trabem/home_sense_meteostation/presentation/PXL_20261026_005536355.jpg

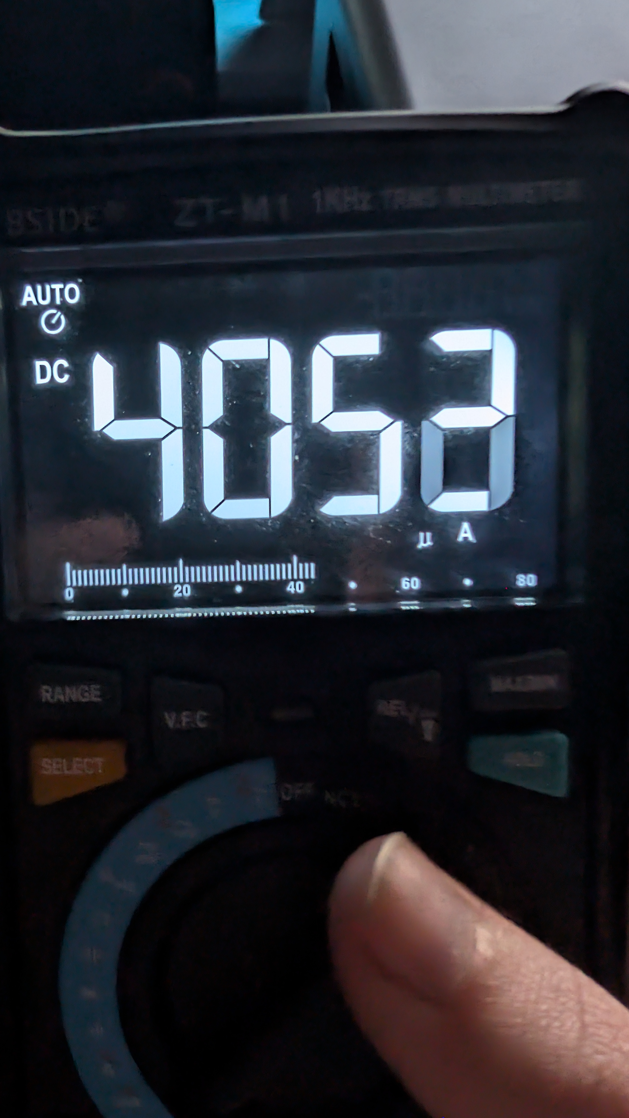
presentation/PXL_20261026_005536355.jpg
