trabem/home_sense_meteostation/presentation/PXL_20261026_134208514.jpg

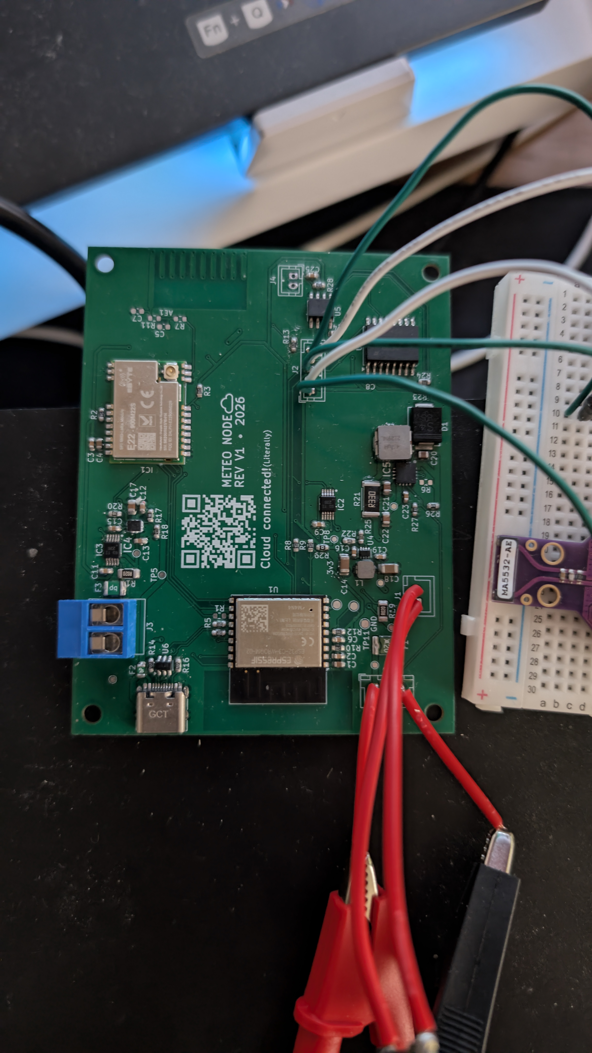
presentation/PXL_20261026_134208514.jpg
