trabem/home_sense_meteostation/presentation/Meteostation_Final_Project_UA_v2_Architecture.pptx

ФІНАЛЬНИЙ ПРОЄКТ КУРСУ

Автономна
метеостанція

Від живлення та датчиків —
до надійної передачі даних

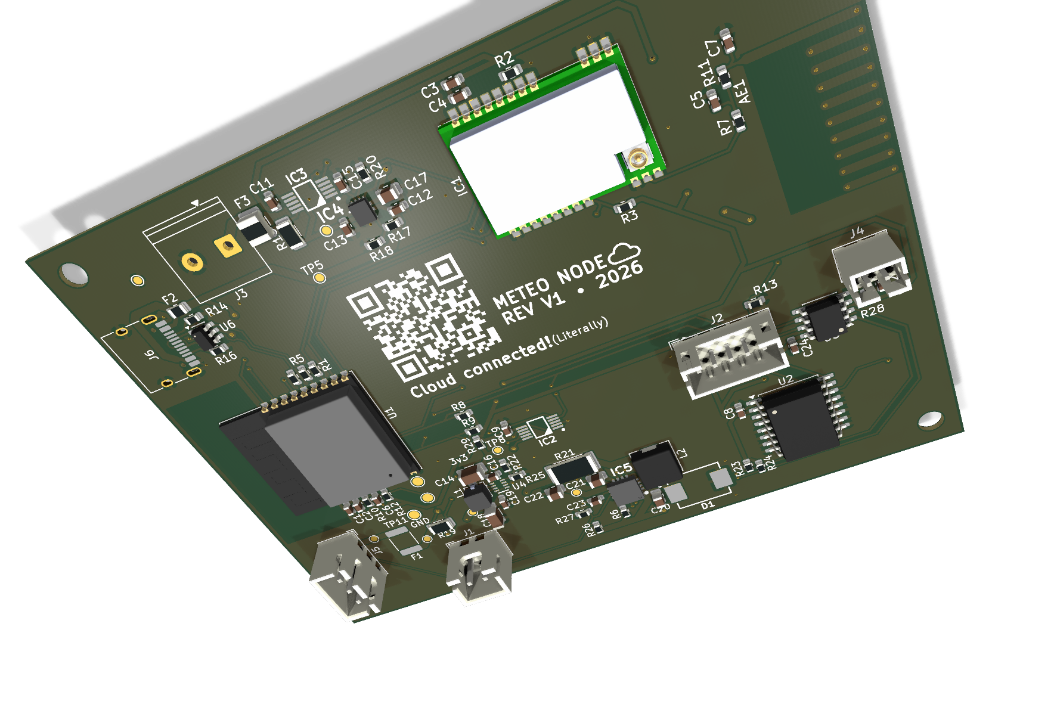
[picture p3: figure]

ESP32-C3 • LoRa / MQTT • Solar / LiFePO₄

KiCad + ESP-IDF + FreeRTOS + C11

2 ПЛАТИ

2 ТРАНСПОРТИ

DEEP SLEEP

01

Апаратна частина • прошивка • протоколи • енергозбереження

Notes: Вітаю! Мій фінальний проєкт — автономна метеостанція на ESP32-C3.
Це не лише програма для мікроконтролера: розроблено дві друковані плати, прошивку та два канали передачі даних.
Основна інженерна ідея — збирати метеодані й енергетичну телеметрію, миттєво реагувати на блискавку та проводити більшість часу в deep sleep.

## Slide 2

01 / ПОСТАНОВКА ЗАДАЧІ

Проблема → інженерна відповідь

Станція має працювати там, де немає постійного живлення та стабільної інфраструктури.

01

Віддалена точка

Живлення від батареї та сонячної панелі; короткі активні цикли.

МЕТА ПРОЄКТУ

Створити автономний
вузол моніторингу

який поєднує вимірювання,
подієву обробку, передачу
даних і контроль живлення.

02

Гроза не чекає таймера

Окреме пробудження через AS3935 і WAKE_IRQ.

03

Різні умови зв’язку

Апаратний вибір LoRa або Wi-Fi + MQTT через J4.

інтервал за замовчуванням

300 с

пристроїв на I²C

6

друковані плати

2

транспорти

2

METEOSTATION / ФІНАЛЬНИЙ ПРОЄКТ

02

Notes: Постановка задачі визначається трьома обмеженнями: автономне живлення, асинхронні грозові події та різні можливості каналу зв’язку.
Тому архітектура не будується навколо постійно активного контролера. Натомість реалізовано цикл пробудження та два незалежні сценарії: періодична телеметрія і блискавка.
Число 300 секунд — конфігурований інтервал за замовчуванням, а не результат вимірювання автономності.

## Slide 3

02 / СИСТЕМА

Система в одному погляді

Один контролер об’єднує датчики, живлення, час і два канали передачі.

USB / SOLAR / LiFePO₄

ESP32-C3

app_flow
sensor_manager
lightning_service
telemetry_codec
power_manager

WAKE → WORK → SLEEP

ISR лише сигналізує
задачу

Wi-Fi

MQTT / JSON

MQTT
broker

ДАТЧИКИ

BME280
AS3935
INA226 ×2
DS3231
PCA9536

I²C 100 кГц

J4

LoRa

binary / TX

LoRa
gateway

01

Один failed sensor
≠ втрата всіх даних

02

03

Транспорт не створює
payload

METEOSTATION / ФІНАЛЬНИЙ ПРОЄКТ

03

Notes: На цій діаграмі видно основні межі системи. Датчики підключені до спільної шини I²C, радіомодуль SX1262 — через SPI.
Прошивка формує предметну модель даних і лише потім обирає кодек і транспорт. Це зменшує зв’язність: драйвер BME280 нічого не знає про MQTT чи LoRa.
Живлення має три джерела: USB, Solar та 1S LiFePO4. J4 вибирає канал, але не вмикає чи вимикає Wi-Fi як окрему функцію.

## Slide 4

03 / АПАРАТНА ЧАСТИНА

Дві плати, один автономний вузол

Основна плата відповідає за керування, живлення й зв’язок; окрема плата — за середовище та грозові події.

ОСНОВНА ПЛАТА • 3D-РЕНДЕР KiCad

METEOSTATION / ФІНАЛЬНИЙ ПРОЄКТ

ESP32-C3-WROOM-02
SX1262 / E22-900M22S
SPI + DIO2 RF-switch

Керування та RF

1S LiFePO₄ • USB • Solar
TP5000 — зарядка
TPS2121 — вибір джерела

Живлення

BME280 — T / P / RH
AS3935 — блискавки
WAKE_IRQ → GPIO1

Плата датчиків

DS3231 + CR2032 зберігають час між циклами

04

Notes: Апаратна частина розділена на основну плату та плату датчиків. Основна плата містить ESP32-C3, LoRa-модуль, RTC, вимірювання живлення та ланцюг TP5000 + TPS2121.
Плата датчиків виносить BME280 і AS3935. Сигнал AS3935 підключений до GPIO1 і використовується як джерело пробудження.
На слайді показано реальний 3D-рендер основної плати з поточного KiCad-проєкту, а не концептуальну ілюстрацію.

## Slide 5

03 / АПАРАТНА ЧАСТИНА

Що саме вимірює станція

Метеодані доповнені власною енергетичною телеметрією та джерелом точного часу.

Середовище

BME280

Грозова подія

distance_km + energy
Фільтрація non-lightning IRQ

AS3935

Енергетика

Battery: U / I / P
Solar: U / I / P

INA226 ×2

°C

температура

Pa

тиск

%RH

вологість

Час

Unix timestamp
CR2032 backup

Стан плати

J4 • CHRG • STDBY

Діагностика

boot count • reset / wake reason
failure counters

0x76 BME280

DS3231

PCA9536

ESP32-C3

I²C

0x03 AS3935

0x40 Solar

0x41 PCA9536

0x44 Battery

0x68 DS3231

METEOSTATION / ФІНАЛЬНИЙ ПРОЄКТ

05

Notes: BME280 дає три базові метеопараметри. AS3935 формує подію з відстанню та, за наявності, енергією.
Два INA226 окремо вимірюють напругу, струм і потужність батареї та сонячного входу. Це дозволяє передавати не лише погоду, а й стан самої автономної системи.
DS3231 дає timestamp, PCA9536 зчитує J4 і стани зарядки. Усі шість пристроїв працюють на одному I²C-bus за адресами, наведеними внизу.

## Slide 6

04 / ПРОШИВКА

Компонентна архітектура ESP-IDF

Чіткі межі між application flow, сервісами, драйверами та транспортами.

app_main • app • app_config • app_flow

APPLICATION

Ключові рішення

• board — єдине джерело GPIO та I²C-адрес
• codecs відокремлені від transports
• один спільний I²C master bus
• bounded buffers і finite timeouts
• мінімальна динамічна алокація після init

PURE C: app_flow + telemetry, без HAL

sensor_manager • lightning_service • power_manager

SERVICES

telemetry/codecs • transport factory • MQTT • LoRa

DATA & CONNECTIVITY

BME280 AS3935 INA226 DS3231 PCA9536 SX1262 board

DRIVERS & BOARD

ESP-IDF 6.0.1 • FreeRTOS • C11+ • NVS / BLE / Wi-Fi

METEOSTATION / ФІНАЛЬНИЙ ПРОЄКТ

06

Notes: Прошивка організована як набір ESP-IDF components. app_main мінімальний; app.c є composition root.
app_flow та telemetry — чисті модулі, які не залежать від периферії та HAL. Драйвери відповідають лише за пристрої, board ізолює фізичний pinout.
Таке розділення спрощує перевірку та зміни: наприклад, формат JSON не проникає в sensor driver, а номер GPIO не дублюється по проєкту.

## Slide 7

05 / АРХІТЕКТУРНІ РІШЕННЯ

Concurrency: мінімум задач, явна синхронізація

Асинхронність ізольована на межах IRQ і мережі; application flow лишається детермінованим.

GPIO IRQ

AS3935 → WAKE_IRQ

vTaskNotifyGiveFromISR

main task

task context

Тому що IRQ —
це сигнал, а не дані

• повідомлення не містить payload
• AS3935 registers читаються пізніше через I²C
• один producer і один main-task consumer
• notification allocation-free і не має queue overflow

ЧОМУ НЕ xQueue?

NETWORK

Wi-Fi / MQTT callback

xEventGroupSetBits

sync wait

task context

RADIO IRQ

SX1262 DIO1

binary semaphore

timed TX

task context

Один application task володіє lifecycle: sensor flow, TX і sleep не перетинаються між задачами.

METEOSTATION / ФІНАЛЬНИЙ ПРОЄКТ

07

Notes: Ключове рішення — не розподіляти сенсори по окремих FreeRTOS tasks. Є один application task, який володіє послідовністю вимірювання, передачі та сну.
Асинхронність потрібна лише на межах: GPIO ISR надсилає direct task notification, Wi-Fi і MQTT callbacks переводяться в EventGroup, SX1262 DIO1 — у binary semaphore. SPI queue_size=1 — це налаштування драйвера, не application queue.
xQueue не використовується для WAKE_IRQ, бо подія не несе payload. Фактичні дані лишаються в регістрах AS3935 і зчитуються вже у task context; це зменшує ISR, heap і клас помилок переповнення черги.

## Slide 8

05 / АРХІТЕКТУРНІ РІШЕННЯ

Persistent queue: свідомо не в V1

Помилка передачі не блокує пристрій і не перетворюється на необмежений backlog.

1

2

3

4

5

SAMPLE

ENCODE

TRANSMIT

RESULT

SLEEP

1–2 повідомлення

static buffers

finite timeout

diagnostics

fresh next wake

ЩО ВИГРАЄМО

без flash wear
без replay / ordering
bounded RAM
менший failure surface

ЯКА ЦІНА

мережева відмова втрачає поточний sample
історія між циклами не зберігається

КОЛИ ДОДАВАТИ

лише за результатами польових даних
як bounded ring buffer

MQTT QoS 1 чекає broker ACK; LoRa TX-only — без ACK. У обох випадках failed message не зберігається в persistent queue.

METEOSTATION / ФІНАЛЬНИЙ ПРОЄКТ

08

Notes: На щіральному слайді я показую не функціональну відсутність, а архітектурний trade-off. Поточний цикл формує максимум boot + telemetry або одну lightning-подію і одразу передає її.
Якщо передача не вдалася, діагностичний лічильник збільшується, активне вікно завершується, пристрій повертається до сну. Це дає bounded memory і не записує кожен цикл у flash.
Ціна — можлива втрата поточного sample під час outage. Persistent queue можна додати лише як bounded ring buffer після польових даних, з окремою перевіркою зносу пам’яті, corruption, ordering і replay. FRAM не входить у V1.

## Slide 9

06 / АВТОНОМНІСТЬ

Deep sleep — основний стан системи

Активний цикл короткий; периферія централізовано переводиться в low-power перед сном.

01

02

03

04

05

06

WAKE

REASON

READ

ENCODE

TX

SLEEP

timer / IRQ

wake routing

лише потрібне

JSON / binary

MQTT / LoRa

low-power

DEEP SLEEP + timer wake + WAKE_IRQ

INA226 power-down • BME280 sleep • SX1262 SetSleep

Wi-Fi / BLE не запускаються в LoRa mode

BATTERY / SOLAR

80 мА / 5–7 с

405 мкА

300 с

Continuous mode

Таймерні цикли без deep sleep
GPIO ISR → task notification
USB живий для flash / monitor

USB DETECTED

ACTIVE

ВИМІРЯНО НА ПЛАТІ: активний цикл 80 мА × 5–7 с • deep sleep 405 мкА • середнє ≈ 1,2 мА у циклі 10 хв

METEOSTATION / ФІНАЛЬНИЙ ПРОЄКТ

09

Notes: Енергозбереження реалізоване як сквозна властивість, а не окремий виклик esp_deep_sleep_start.
Перед сном prepare_sleep послідовно зупиняє мережеві функції, вимикає INA226, переводить BME280 і SX1262 у сон, налаштовує timer та GPIO wake.
Виміряне споживання всієї плати: 80 мА під час активного циклу тривалістю 5–7 секунд і 405 мкА у deep sleep. За штатного інтервалу 10 хвилин це дає середній струм близько 1,2 мА; основний внесок у циклі — активна фаза, а у добовому балансі — струм сну.
405 мкА значно перевищує deep sleep самого ESP32-C3 (одиниці мкА), отже головний резерв оптимізації — периферія та ланцюги живлення плати.
Для USB передбачено continuous mode: зручно налагоджувати плату, моніторити лог і працювати з provisioning без автоматичного засинання.

## Slide 10

06 / ПОДІЄВА ОБРОБКА

Блискавка: окремий швидкий сценарій

Подія не чекає наступного періодичного вимірювання.

AS3935

IRQ

GPIO1

WAKE_IRQ

SERVICE

reason?

CODEC

distance + energy

TX

MQTT / LoRa

Disturber / noise не створюють хибну подію блискавки.

ВАЛІДАЦІЯ ПЕРЕРИВАННЯ

reason == lightning?

МІНІМАЛЬНИЙ ШЛЯХ

RTC + AS3935

BME280 / INA226

Після TX → одразу low-power → sleep

ТАК → ПОДІЯ

НІ → БЕЗ TX

Читаємо:

Не читаємо:

METEOSTATION / ФІНАЛЬНИЙ ПРОЄКТ

10

Notes: Блискавка є другим, незалежним сценарієм. WAKE_IRQ будить контролер, після чого lightning_service обов’язково зчитує причину переривання AS3935.
Якщо причина не lightning, жодна подія не передається. Якщо подія підтверджена, надсилаються timestamp, distance та energy за наявності.
У цьому циклі навмисно не зчитуються BME280 і INA226: коротший шлях зменшує затримку й активний час.

## Slide 11

07 / ЗВ’ЯЗОК

J4 — явний вибір транспорту

Немає прихованого automatic fallback: режим визначає апаратний перемикач.

LoRa

Енергоощадний default

• SX1262 / E22-900M22S
• 868.1 MHz • SF7 • BW 125 kHz
• 14 dBm • TX timeout 5 s
• TX-only: без RX / ACK / retries
• binary little-endian, versioned

J4 OPEN / HIGH

Wi-Fi + MQTT

Зручна інтеграція з інфраструктурою

• JSON • QoS 1 за замовчуванням
• mqtts:// + certificate verification
• BLE provisioning без credentials
• SNTP лише за невалідного RTC
• SX1262 одразу переводиться в sleep

3 TOPICS: telemetry / events / status

J4 CLOSED / LOW

Wi-Fi / BLE НЕ ЗАПУСКАЮТЬСЯ

METEOSTATION / ФІНАЛЬНИЙ ПРОЄКТ

11

Notes: J4 — це свідомий вибір архітектури зв’язку. Розімкнений J4 відповідає LoRa і є безпечним за замовчуванням варіантом: Wi-Fi і BLE узагалі не ініціалізуються.
Замкнений J4 вмикає сценарій Wi-Fi + MQTT. Якщо credentials відсутні, запускається BLE provisioning. LoRa працює TX-only — це не LoRaWAN і немає ACK чи retries.
Автоматичний fallback Wi-Fi до LoRa відсутній, тож поведінка пристрою передбачувана.

## Slide 12

08 / ДАНІ

Два формати — одна предметна модель

telemetry_codec формує payload; transports лише передають готовий буфер.

Людиночитаний формат

{
"schema": 1,
"device_id": "meteo-a17c42",
"timestamp": 1735689600,
"environment": {
"temperature_c": 21.54,
"humidity_percent": 48.26,
"pressure_pa": 100812
},
"transport": "wifi"
}

Фрагмент telemetry; battery / solar додаються за валідності.

MQTT / JSON

Компактний versioned frame

little-endian • protocol_version = 1

Flags визначають наявність env / battery / solar.
Невалідний датчик не робить увесь кадр непридатним.

LORA / BINARY

0

ver

1

type

2..5

device

6..9

time

10

flags

…

valid data

39 B

telemetry max

12/16 B

lightning

15 B

boot

METEOSTATION / ФІНАЛЬНИЙ ПРОЄКТ

12

Notes: Обидва транспорти використовують спільну предметну модель, але різні кодеки. MQTT отримує JSON, LoRa — компактний binary frame.
У LoRa-заголовку є версія протоколу, тип повідомлення, hash пристрою, timestamp і flags. Поля даних присутні лише за відповідних validity bits.
Максимальний telemetry frame — 39 байт; lightning — 12 або 16; boot — 15. JSON на слайді є ілюстративним фрагментом, не точним шаблоном усіх полів.

## Slide 13

09 / ЯКІСТЬ РІШЕННЯ

Надійність і безпека закладені в потік

Система розрахована на відмови окремих датчиків, мережеві затримки та безпечне первинне налаштування.

Partial telemetry

Один failed sensor не блокує решту; validity flags зберігають межі достовірності.

01

Finite timeouts

I²C, Wi-Fi, MQTT, BUSY і LoRa TX мають межі; немає нескінченних retries.

02

Power invariants

Перед сном централізовано вимикаються Wi-Fi / BLE та периферія.

03

MQTT over TLS

Production — mqtts://; skip certificate verification лише як explicit dev-flag.

BLE provisioning

Per-device PoP із factory MAC; credentials у NVS; секрети не логуються.

Захист від збоїв

Watchdog і brownout detector enabled; diagnostics рахують помилки.

04

05

06

METEOSTATION / ФІНАЛЬНИЙ ПРОЄКТ

13

Notes: Надійність проявляється насамперед у graceful degradation: частина телеметрії може бути валідною навіть за відмови одного датчика.
Усі зовнішні операції обмежені часом, Wi-Fi має максимум три спроби підключення, після чого пристрій повертається до сну.
Безпека: production MQTT використовує TLS з перевіркою сертифіката; BLE provisioning має унікальний per-device PoP. Паролі та PoP не повинні потрапляти в логи. Watchdog і brownout залишаються увімкненими.

## Slide 14

10 / ПІДСУМОК

Результат і межі поточної версії

Завершений інженерний прототип V1 — з чесно визначеним обсягом та подальшими кроками.

• Дві KiCad-плати та fabrication outputs
• ESP-IDF firmware з компонентною структурою
• Періодична telemetry + lightning events
• LoRa binary та Wi-Fi + MQTT JSON
• Deep sleep, USB continuous, BLE provisioning

METEOSTATION / ФІНАЛЬНИЙ ПРОЄКТ

РЕАЛІЗОВАНО

Немає backend / web UI / OTA
LoRa без RX, ACK, retries і LoRaWAN
Немає persistent telemetry queue

МЕЖІ V1

Польові випробування; зниження sleep-струму 405 мкА
Візуалізація даних у зовнішньому backend
Оцінка потреби в queue / OTA за результатами

ДАЛІ

14

Notes: Результат — цілісний інженерний прототип: hardware, firmware, протоколи, provisioning та енергозбереження.
При цьому V1 свідомо не містить backend, web UI, OTA, LoRaWAN чи persistent queue. Це не приховані недоробки, а зафіксовані межі обсягу.
Наступний практичний крок — польові випробування та зниження струму сну: виміряні 405 мкА помітно перевищують deep sleep самого ESP32-C3, тож резерв автономності — у периферії та живленні. Саме ці дані мають визначити, чи потрібні черга повідомлень, OTA або інші розширення.

## Slide 15

ФІНАЛЬНИЙ ПРОЄКТ

Дякую за увагу

Питання?

wake → measure → transmit → sleep

Автономна метеостанція поєднує

HARDWARE

2 плати • power • sensors

FIRMWARE

C11 • ESP-IDF • FreeRTOS

DATA

LoRa binary • MQTT JSON

QUALITY

partial telemetry • finite timeouts

ESP32-C3 / KiCad / ESP-IDF / LoRa / MQTT

15

Notes: Дякую за увагу!
Головний результат проєкту — не окремий датчик чи бібліотека, а завершений ланцюжок: живлення → вимірювання → обробка → передача → сон.
Готовий відповісти на питання про схемотехніку, структуру прошивки, формати даних та енергозбереження.
