trabem/home_sense_meteostation/presentation/assets/sensor_board_3d.png

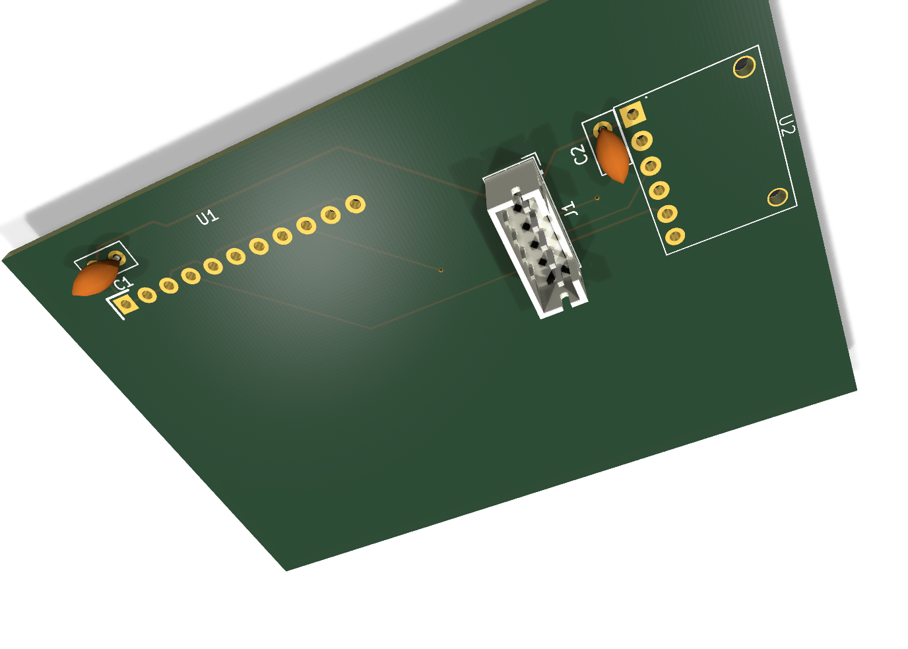
presentation/assets/sensor_board_3d.png
