trabem/home_sense_meteostation/presentation/preview/contact_1.png

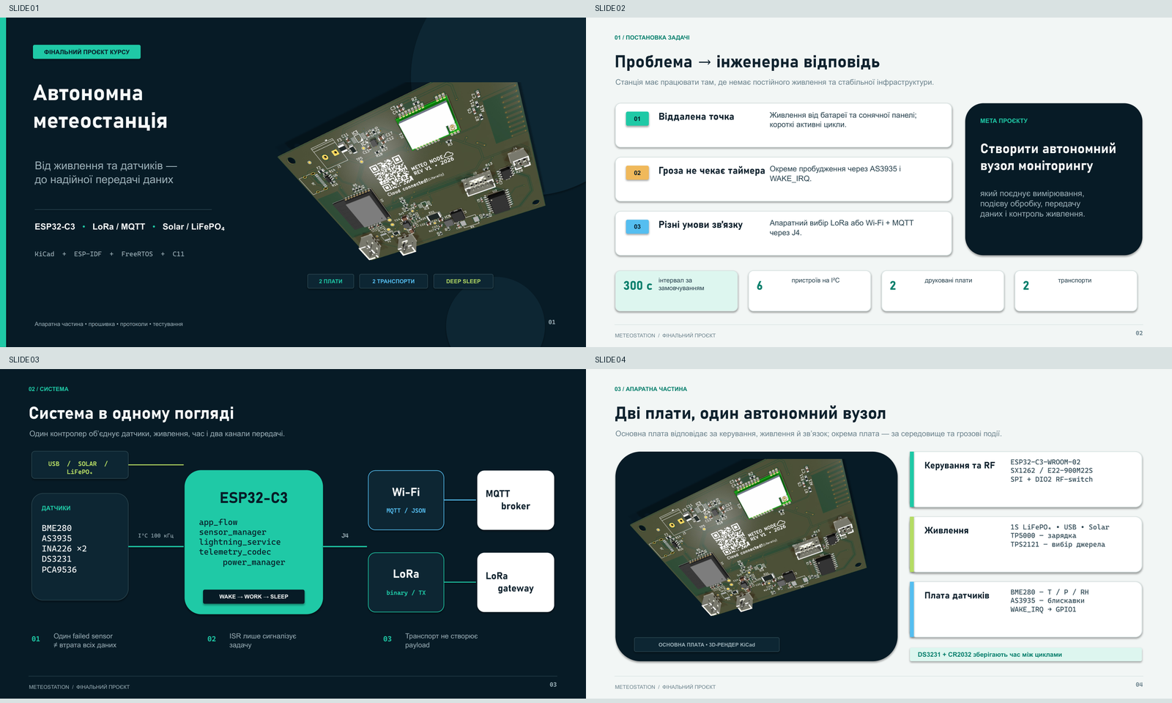
presentation/preview/contact_1.png
