trabem/home_sense_meteostation/presentation/preview/contact_2.png

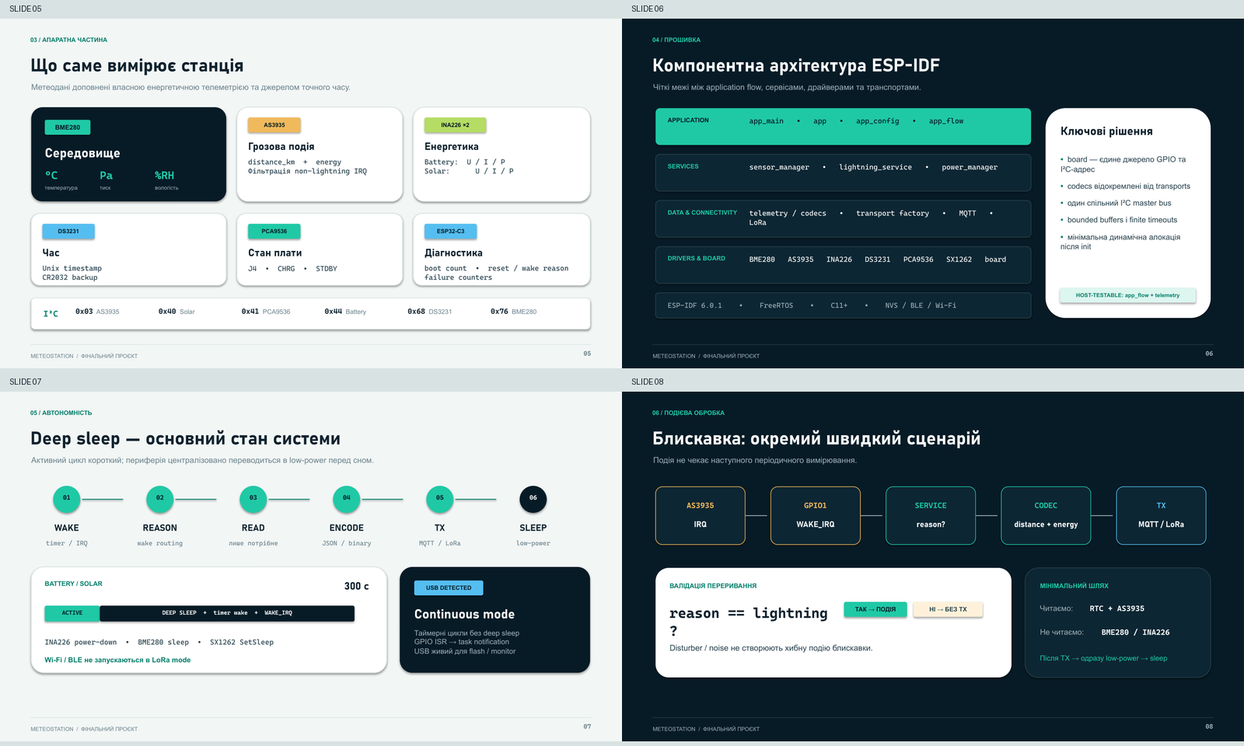
presentation/preview/contact_2.png
