trabem/home_sense_meteostation/presentation/preview/contact_3.png

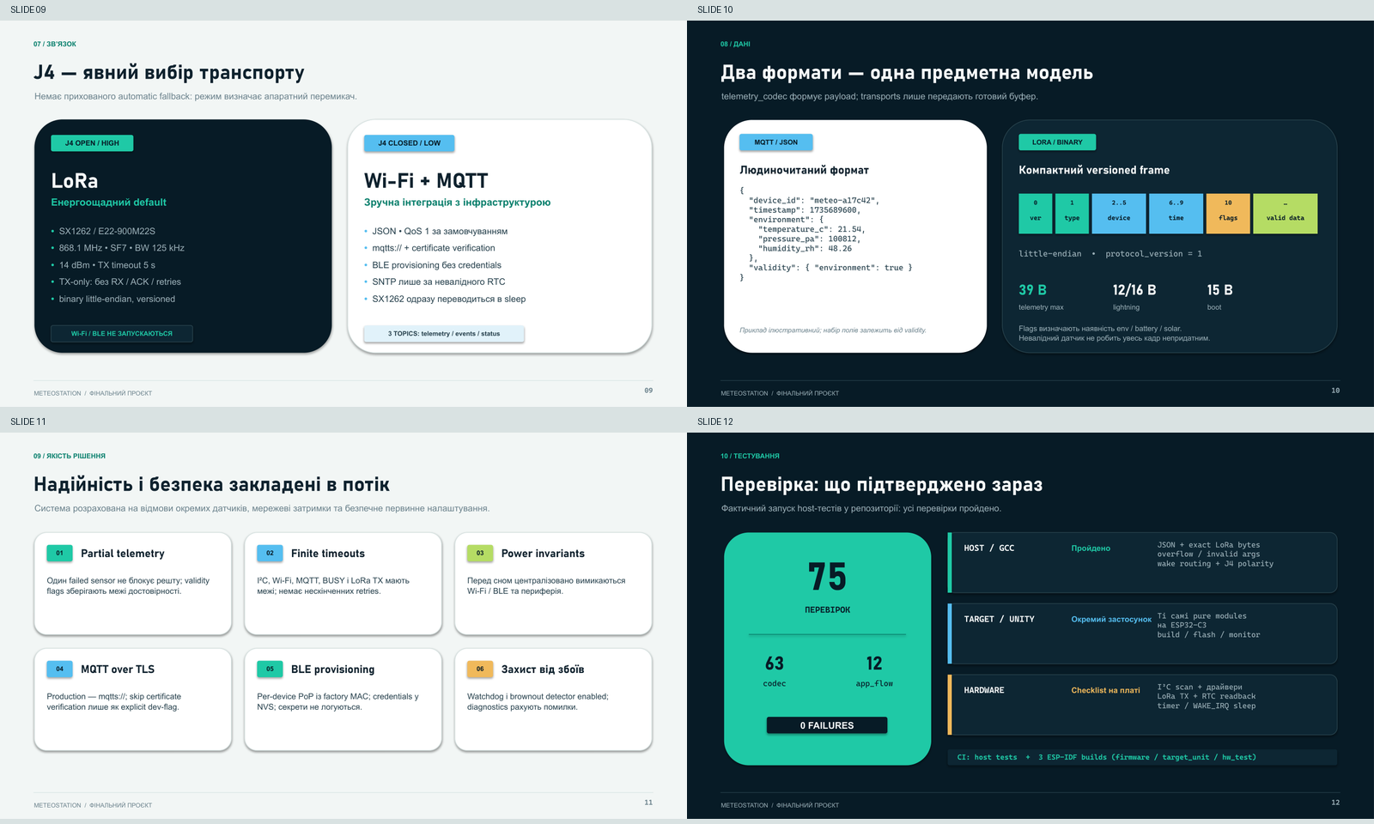
presentation/preview/contact_3.png
