trabem/home_sense_meteostation/presentation/preview/contact_4.png

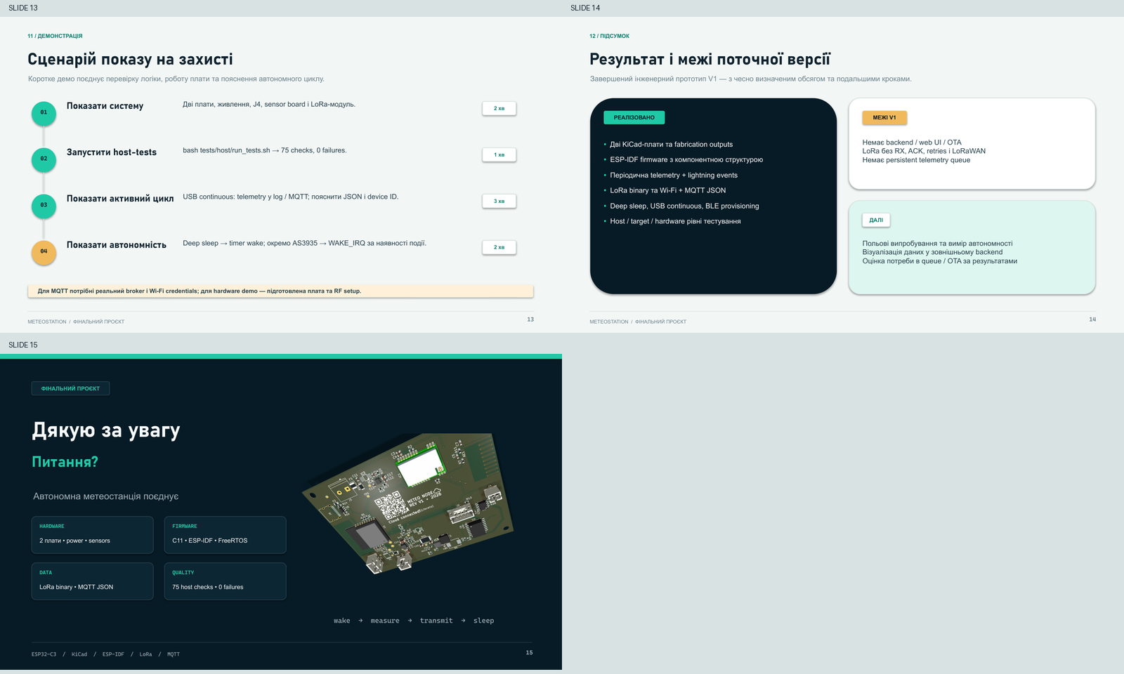
presentation/preview/contact_4.png
