trabem/home_sense_meteostation/presentation/preview/slide_01.png

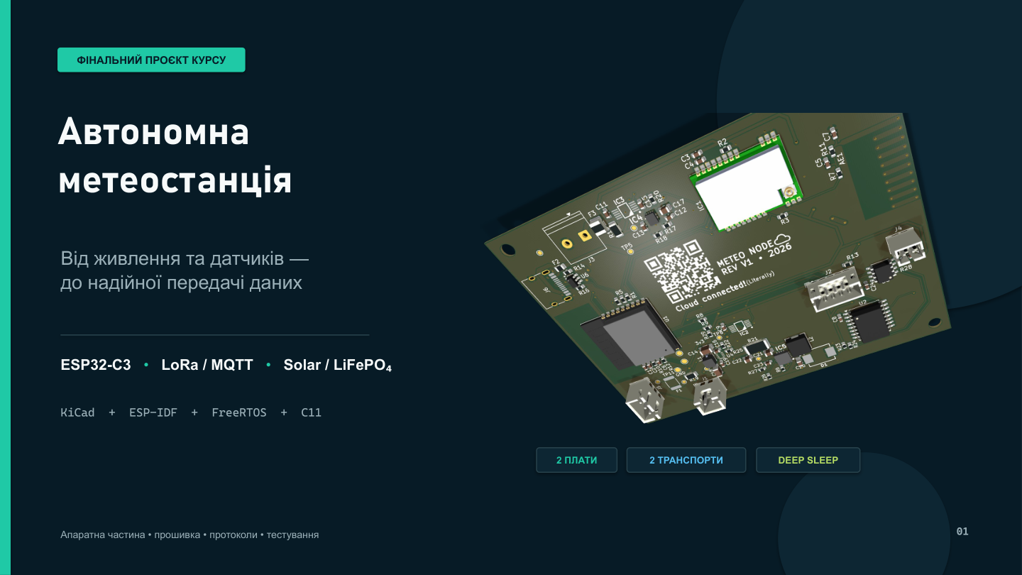
presentation/preview/slide_01.png
