trabem/home_sense_meteostation/presentation/preview/slide_02.png

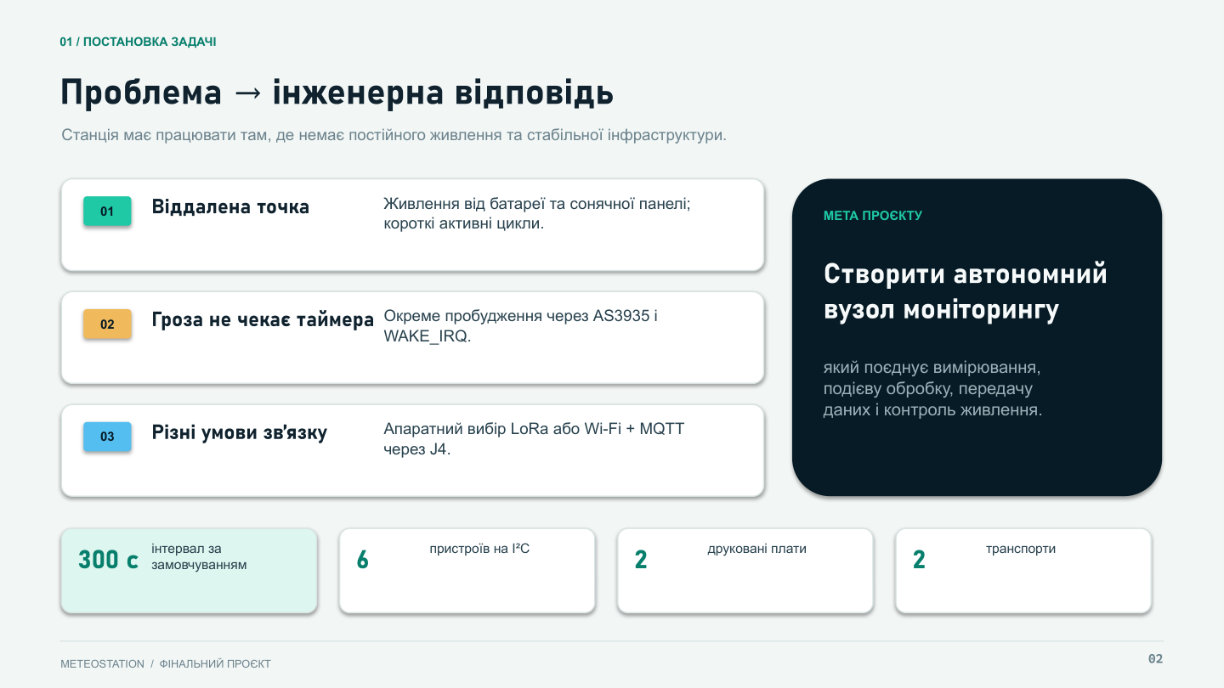
presentation/preview/slide_02.png
