trabem/home_sense_meteostation/presentation/preview/slide_03.png

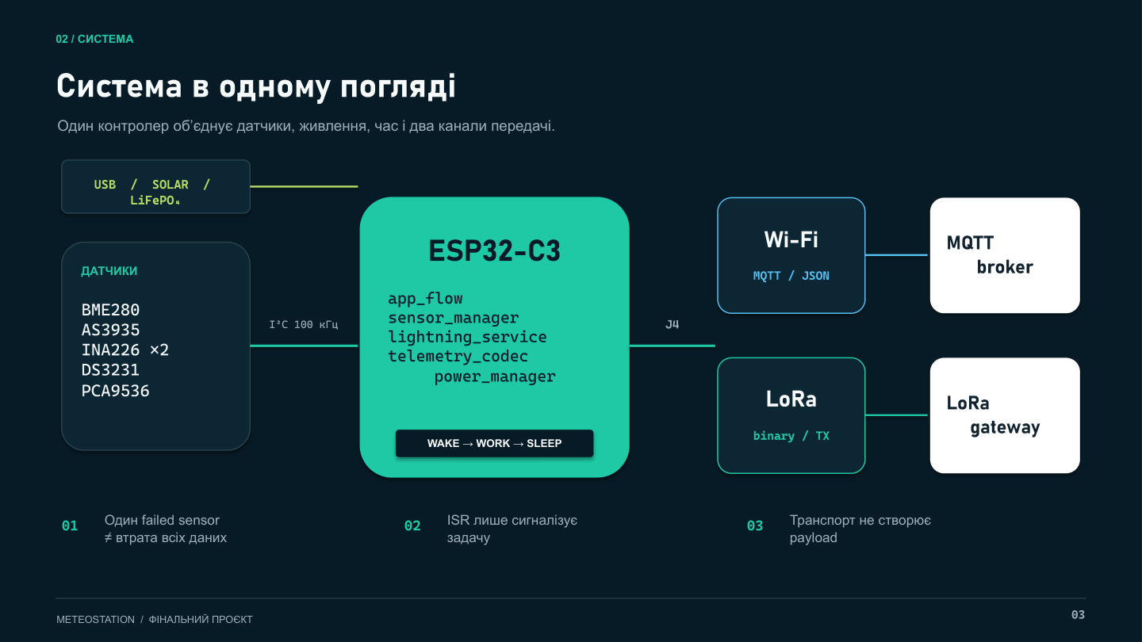
presentation/preview/slide_03.png
