trabem/home_sense_meteostation/presentation/preview/slide_04.png

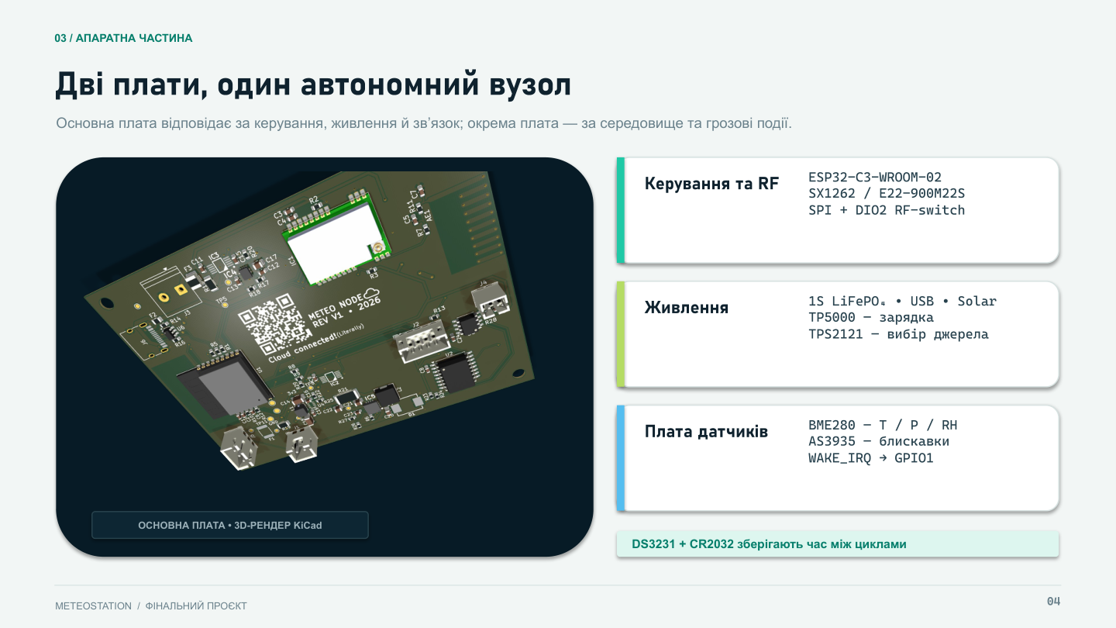
presentation/preview/slide_04.png
