trabem/home_sense_meteostation/presentation/preview/slide_05.png

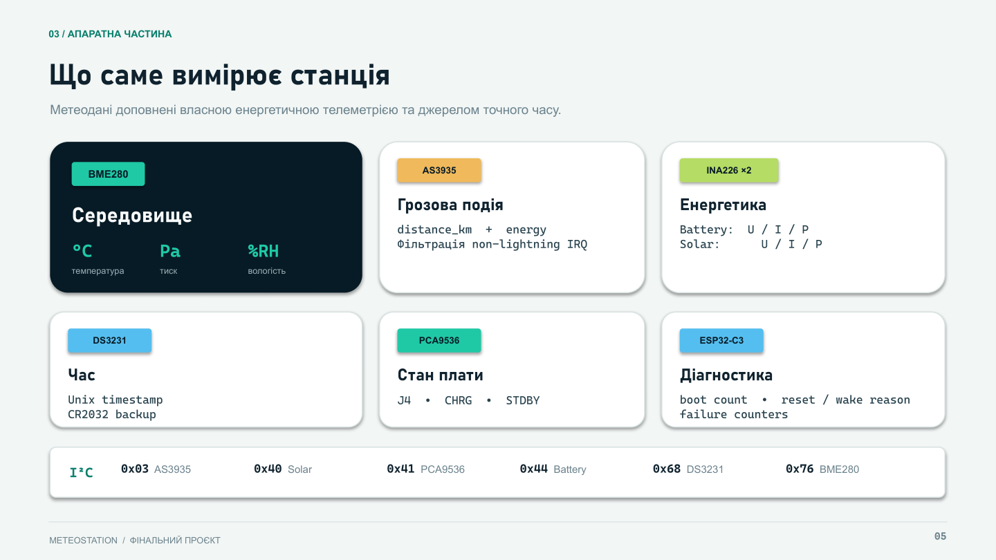
presentation/preview/slide_05.png
