trabem/home_sense_meteostation/presentation/preview/slide_06.png

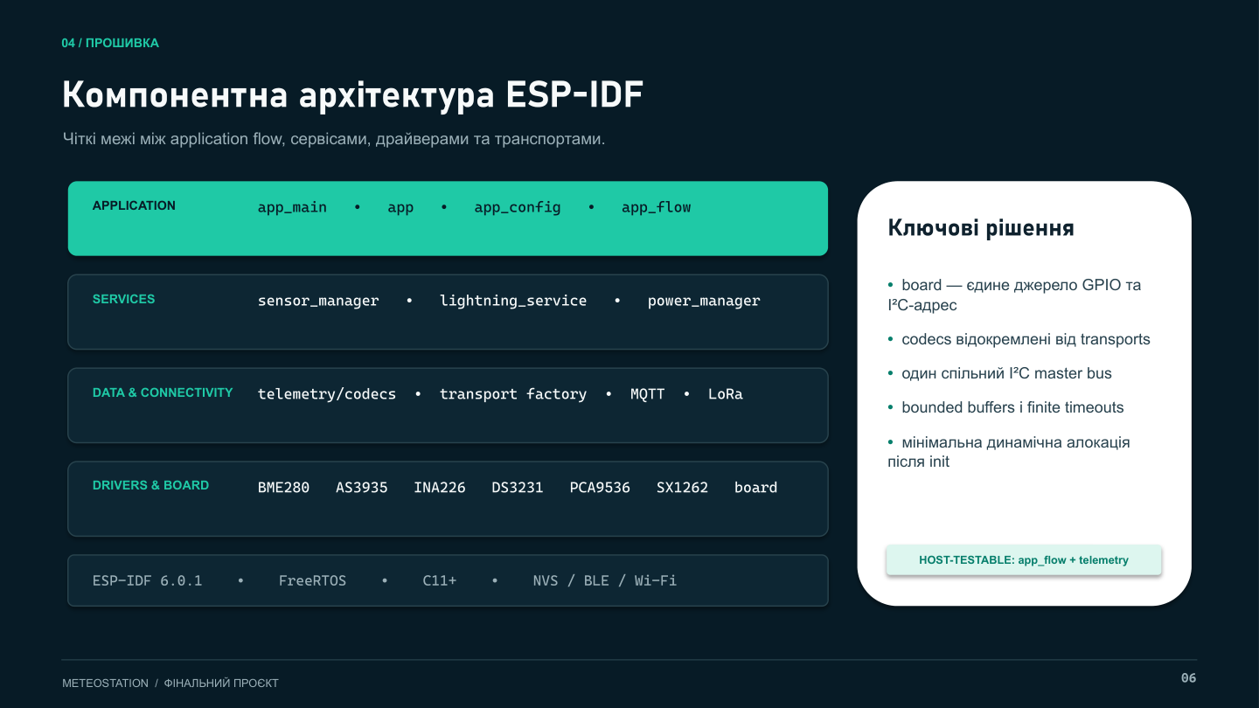
presentation/preview/slide_06.png
