trabem/home_sense_meteostation/presentation/preview/slide_07.png

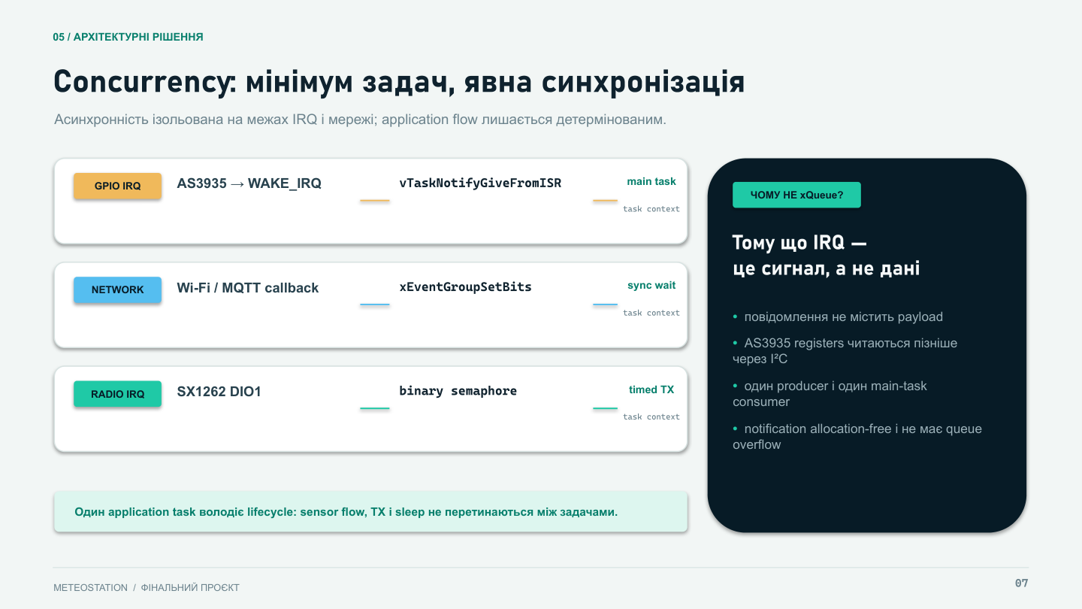
presentation/preview/slide_07.png
