trabem/home_sense_meteostation/presentation/preview/slide_08.png

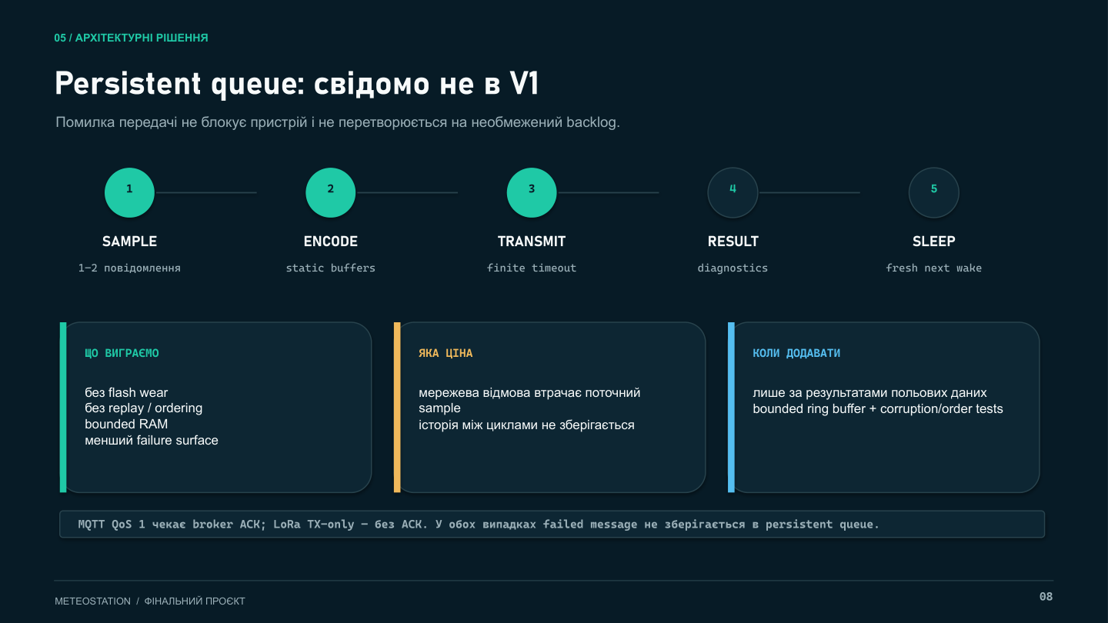
presentation/preview/slide_08.png
