trabem/home_sense_meteostation/presentation/preview/slide_09.png

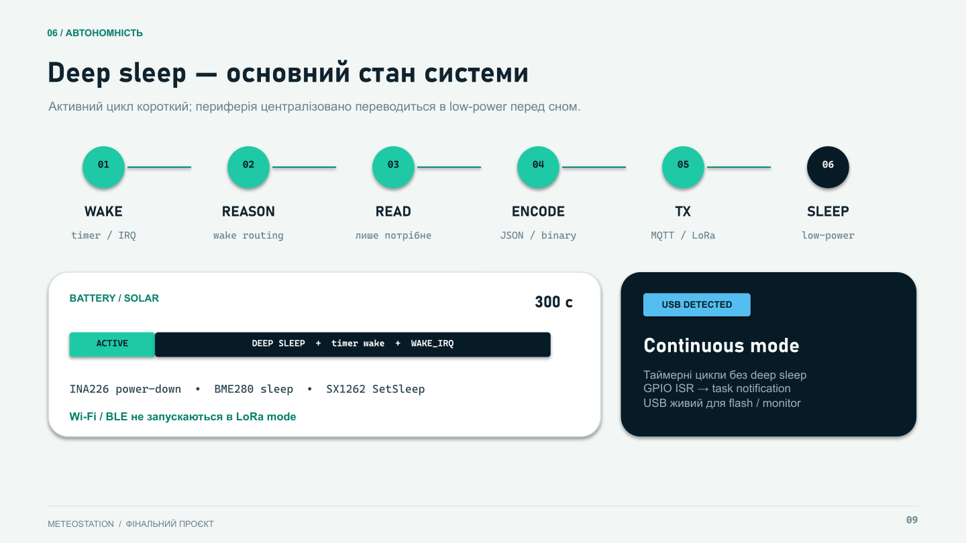
presentation/preview/slide_09.png
