trabem/home_sense_meteostation/presentation/preview/slide_10.png

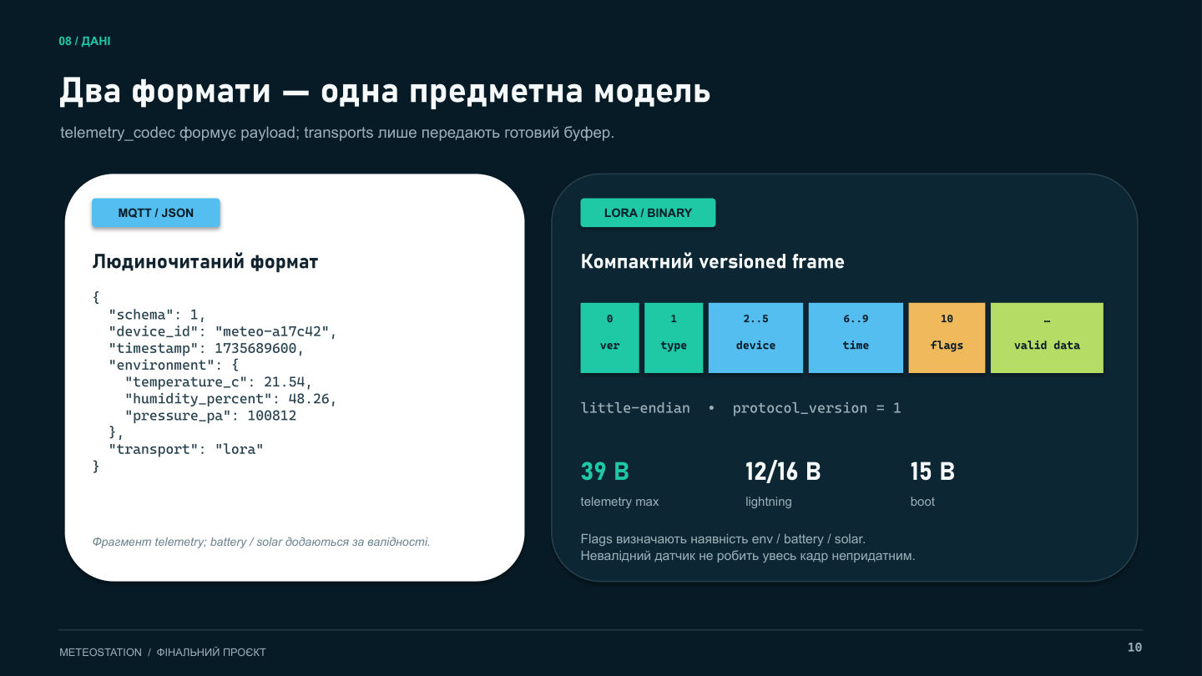
presentation/preview/slide_10.png
