trabem/home_sense_meteostation/presentation/preview/slide_11.png

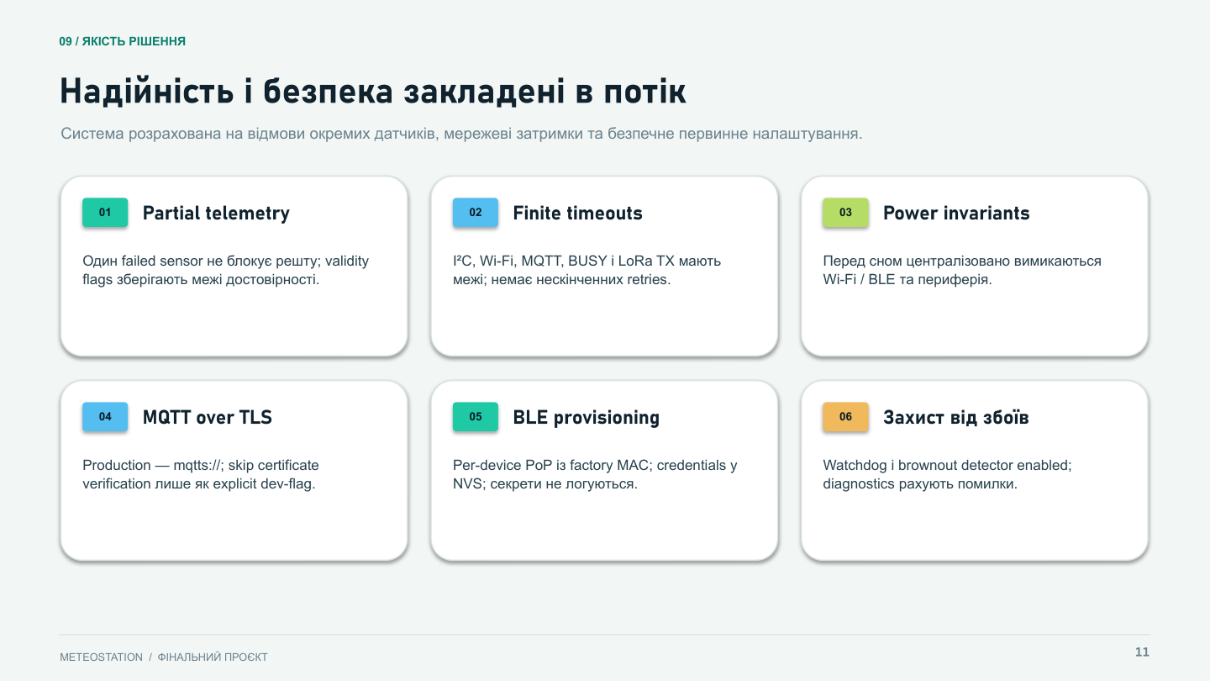
presentation/preview/slide_11.png
