trabem/home_sense_meteostation/presentation/preview/slide_12.png

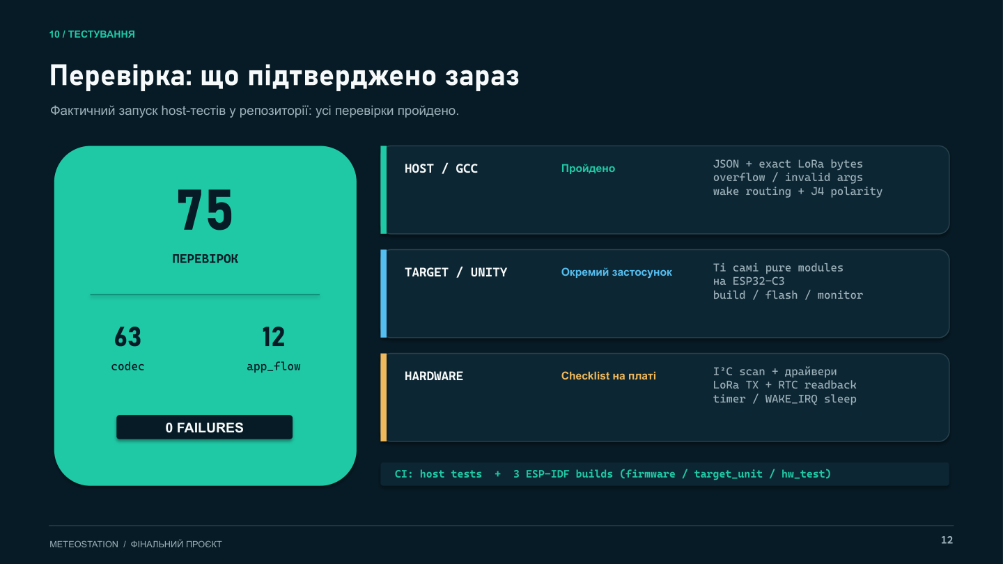
presentation/preview/slide_12.png
