trabem/home_sense_meteostation/presentation/preview/slide_13.png

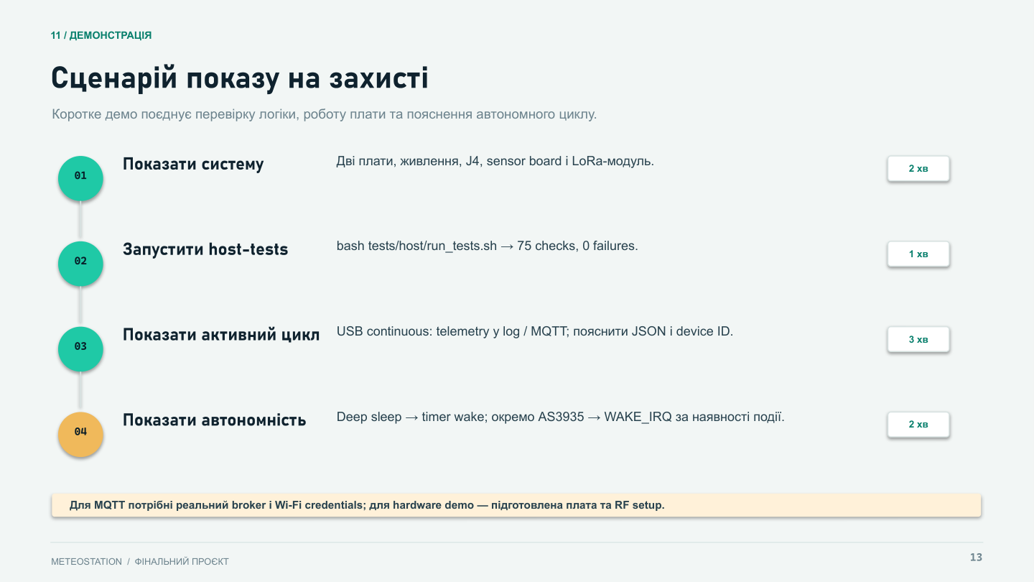
presentation/preview/slide_13.png
