trabem/home_sense_meteostation/presentation/preview/slide_14.png

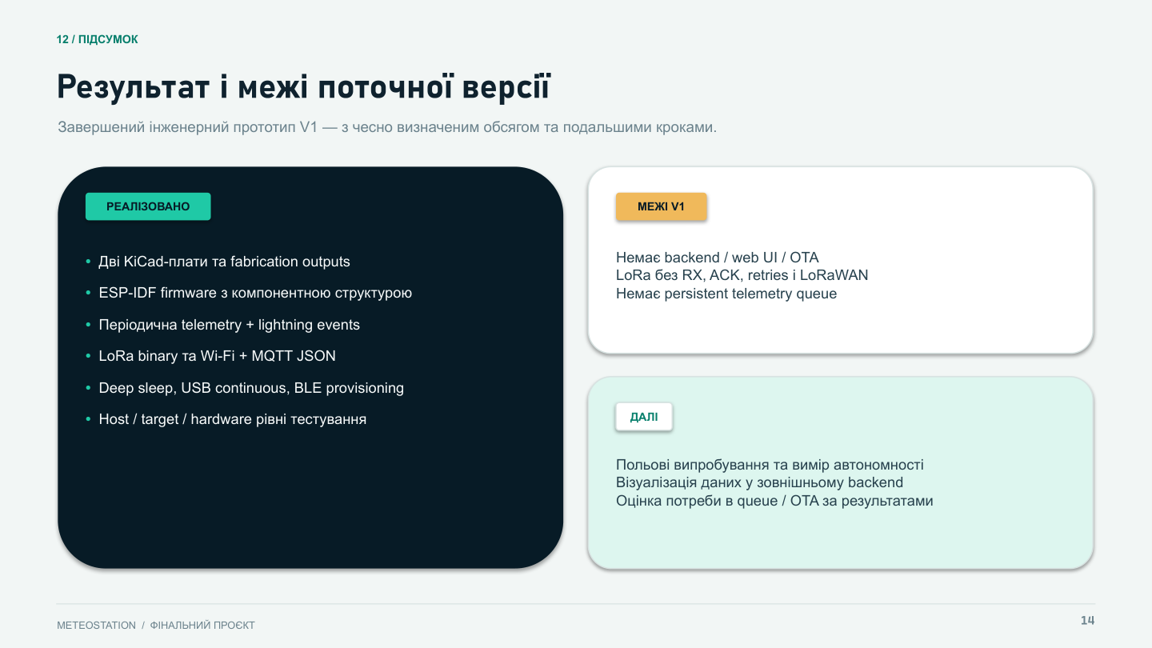
presentation/preview/slide_14.png
