trabem/home_sense_meteostation/presentation/preview/slide_15.png

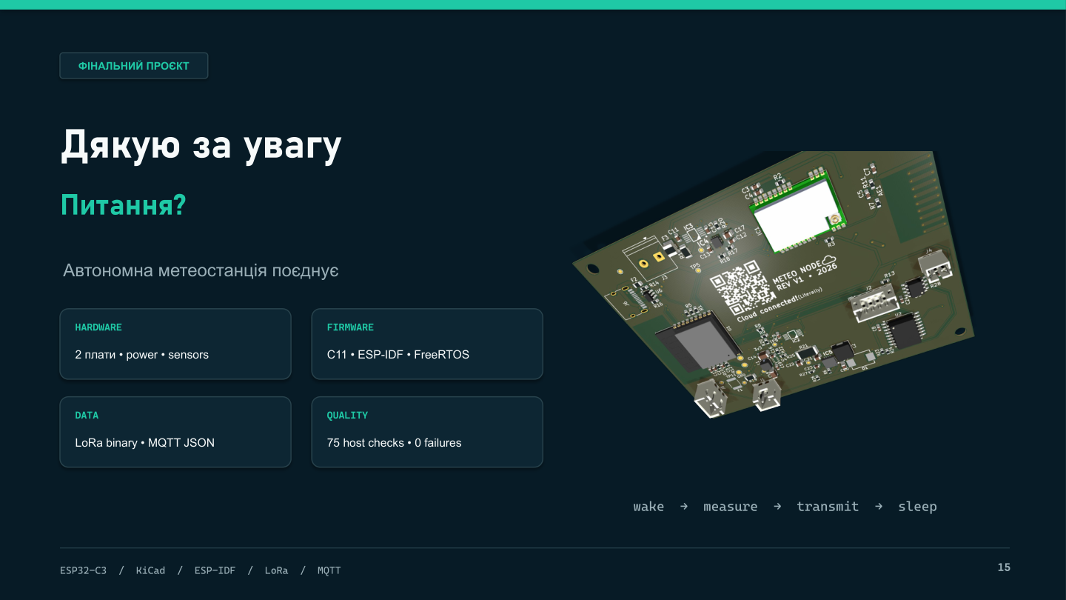
presentation/preview/slide_15.png
