trabem/home_sense_meteostation/hardware/main_board/main_board.csv

# | Reference | Qty | Value | Footprint | Comment
1 | AE1 | 1 | Antenna | RF_Antenna:Texas_SWRA416_868MHz_915MHz
2 | BT1 | 1 | CR2032 | Battery:BatteryHolder_Multicomp_BC-2001_1x2032
3 | C1,C4 | 2 | 10uF | Capacitor_SMD:C_0603_1608Metric | X5R/X7R, ≥10 V | +
4 | C2,C3,C8,C9,C11,C15,C16,C19,C23,C24,C25 | 11 | 100nF | Capacitor_SMD:C_0603_1608Metric | X7R, ±10%, 16 V | +
5 | C5,C7 | 2 | DNP | Capacitor_SMD:C_0603_1608Metric |  | -
6 | C6,C12,C13 | 3 | 1uF | Capacitor_SMD:C_0603_1608Metric | X7R, ±10%, 16 V,X7R, ±10%, ≥10 V | +
7 | C14 | 1 | 47uF | Capacitor_SMD:C_1206_3216Metric | X5R/X7R, ≥6.3 V, preferably 10 V; check DC-bias derating | +
8 | C17 | 1 | 4.7uF | Capacitor_SMD:C_0805_2012Metric | X7R/X5R, ≥10 V, 16 V preferred | +
9 | C18 | 1 | 22uF | Capacitor_SMD:C_1206_3216Metric | X5R/X7R, ≥6.3 V, preferably 10 V | +
10 | C20,C21,C22 | 3 | 10uF | Capacitor_SMD:C_0805_2012Metric | X5R/X7R, ≥10 V, 16 V preferred,X5R/X7R, ≥6.3 V, preferably 10 V | +
11 | D1 | 1 | SS34 | ICs And Semiconductors SMD:DO-214AB |  | +
12 | F1 | 1 | MINISMDC200F-2 | Fuse:Fuse_1812_4532Metric |  | +
13 | F2 | 1 | 0ZCK0075FF2E | Fuse:Fuse_0805_2012Metric |  | +
14 | F3 | 1 | 0ZCH0075AF2E | Fuse:Fuse_1210_3225Metric |  | +
15 | IC1 | 1 | E22-900M22S | E22-900M22S:E22-900M22S
16 | IC2,IC3 | 2 | INA226AIDGST | ICs And Semiconductors SMD:SOP50P490X110-10N | INA226AIDGST | +
17 | IC4 | 1 | TPS2121RUXT | TPS2121RUXT:TPS2121RUXT |  | +
18 | IC5 | 1 | TP5000-QFN16 | TP5000-QFN16:QFN65P400X400X90-17N-D |  | +
19 | J1 | 1 | power swith | Connector_JST:JST_XH_B2B-XH-A_1x02_P2.50mm_Vertical
20 | J2 | 1 | I2C External Modules | Connector_JST:JST_PH_B5B-PH-K_1x05_P2.00mm_Vertical
21 | J3 | 1 | Solar panel | TerminalBlock_Philmore:TerminalBlock_Philmore_TB132_1x02_P5.00mm_Horizontal
22 | J4 | 1 | WI-FI switch | Connector_JST:JST_PH_B2B-PH-K_1x02_P2.00mm_Vertical
23 | J5 | 1 | Battary over BMS | Connector_JST:JST_XH_B3B-XH-A_1x03_P2.50mm_Vertical
24 | J6 | 1 | USB4105-GF-A-060 | Connector_USB:USB_C_Receptacle_HRO_TYPE-C-31-M-12
25 | L1 | 1 | IHLP1212BZER1R0M11 | IHLP1212BZER1R0M11:IND_IHLP1212BZER1R0M11 |  | +
26 | L2 | 1 | 4.7 uH | Inductor_SMD:L_Chilisin_BMRA00050520 |  | +
27 | R1,R6 | 2 | 0R | Resistor_SMD:R_0603_1608Metric | 0R configuration jumper | -
28 | R2,R3,R10,R12,R23,R24 | 6 | 10k | Resistor_SMD:R_0603_1608Metric |  | +
29 | R4,R5 | 2 | 22R | Resistor_SMD:R_0603_1608Metric |  | +
30 | R7,R11,R29 | 3 | 0R | Resistor_SMD:R_0603_1608Metric | 0R configuration jumper,RF matching element. Populate 0R initially. Value may be changed after VNA tuning. | +-
31 | R8,R9 | 2 | 4.7k | Resistor_SMD:R_0603_1608Metric |  | +
32 | R13,R18,R28 | 3 | 47k | Resistor_SMD:R_0603_1608Metric | Priority / threshold divider, ±1% | +
33 | R14,R16 | 2 | 5.1k | Resistor_SMD:R_0603_1608Metric |  | +
34 | R15,R19 | 2 | 20mR | Resistor_SMD:R_1206_3216Metric | current sense, ±1% або краще, low-TCR ≤50 ppm/°C, ≥0.5 W,current sense, ±1%/±0.5%, low-TCR ≤50 ppm/°C, ≥0.5 W recommended | +
35 | R17 | 1 | 150k | Resistor_SMD:R_0603_1608Metric | Priority / threshold divider, ±1% | +
36 | R20 | 1 | 80k | Resistor_SMD:R_0603_1608Metric | TPS2121 ILIM programming resistor, ±1%. Value change affects current limit. | ?
37 | R21 | 1 | 330mR | Resistor_SMD:R_2512_6332Metric | current/charge setting resistor, ±1%, low-TCR, ≥1 W | +
38 | R22 | 1 | 511k | Resistor_SMD:R_0603_1608Metric | VOUT feedback divider — precision resistors, ±0.5% or better, ≤50 ppm/°C. Sets 3.3 V output. | +
39 | R25 | 1 | 91k | Resistor_SMD:R_0603_1608Metric | VOUT feedback divider — precision resistors, ±0.5% or better, ≤50 ppm/°C. Sets 3.3 V output. | +
40 | R26 | 1 | 4.87k | Resistor_SMD:R_0603_1608Metric | Programming / sensing network — ±1%, do not substitute without recalculation. | +
41 | R27 | 1 | 44.2k | Resistor_SMD:R_0603_1608Metric | Programming / sensing network — ±1%, do not substitute without recalculation. | +
42 | TP1 | 1 | TP_SOLAR_IN | TestPoint:TestPoint_Pad_D1.0mm
43 | TP2 | 1 | TP_BAT_RAW | TestPoint:TestPoint_Pad_D1.0mm
44 | TP3 | 1 | TP_BAT_FUSED | TestPoint:TestPoint_Pad_D1.0mm
45 | TP4 | 1 | TP_BAT_SYSTEM | TestPoint:TestPoint_Pad_D1.0mm
46 | TP5 | 1 | TP_USB_5V | TestPoint:TestPoint_Pad_D1.0mm
47 | TP6 | 1 | ESP32_EN | TestPoint:TestPoint_Pad_D1.5mm
48 | TP7 | 1 | TP_BAT_SW | TestPoint:TestPoint_Pad_D1.0mm
49 | TP8 | 1 | TP_3V3 | TestPoint:TestPoint_Pad_D1.0mm
50 | TP9 | 1 | TP_GND_PWR | TestPoint:TestPoint_Pad_D1.0mm
51 | TP10 | 1 | ESP32_BOOT | TestPoint:TestPoint_Pad_D1.5mm
52 | U1 | 1 | ESP32-C3-WROOM-02 | RF_Module:ESP32-C3-WROOM-02
53 | U2 | 1 | DS3231SN | Package_SO:SOIC-16W_7.5x10.3mm_P1.27mm |  | +
54 | U4 | 1 | TPS631000DRLR | TPS631000DRLR:TPS631000DRLR_TEX |  | +
55 | U5 | 1 | PCA9536DR | Package_SO:SOIC-8_3.9x4.9mm_P1.27mm |  | +
56 | U6 | 1 | USBLC6-2SC6 | Package_TO_SOT_SMD:SOT-23-6 |  | +
