trabem/home_sense_meteostation/hardware/main_board/main_board.step

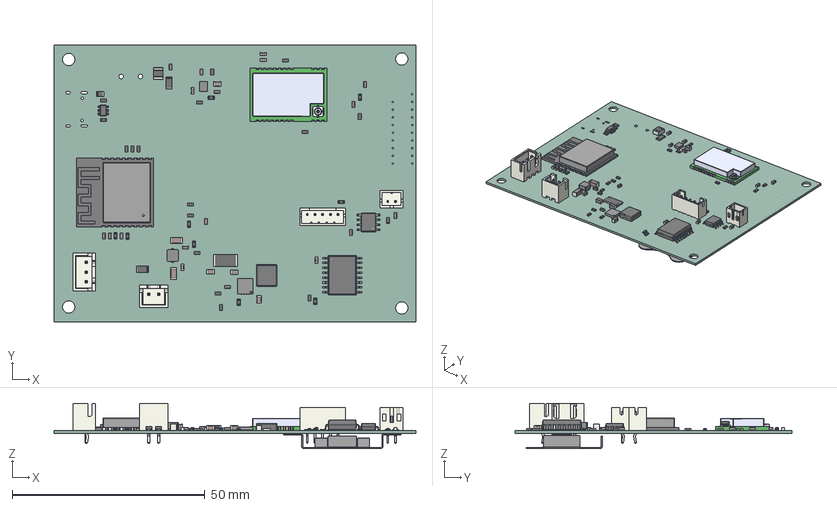
[picture p24: CAD file, 2026-10-23]
hardware/main_board/main_board.step
94.0 x 72.0 x 11.7 mm
R_0603_1608Metric x 26
C_0603_1608Metric x 18
JST_B2B_XH_A
JST_B2B_PH_K
C_0805_2012Metric x 4
R_1206_3216Metric x 2
JST_B5B_PH_K
SOIC-8_3.9x4.9mm_P1.27mm
E22-900M22S_E22-900M22S
ThermalPin
PinsArrayLR
PinsArrayTB
JST_B3B_XH_A
b9c05f24-8551-11ed-b402-00155d22e2d7_part
b9c0610e-8551-11ed-b402-00155d22e2d7_part
b9c061b8-8551-11ed-b402-00155d22e2d7_part
Fuse_0805_2012Metric
R_2512_6332Metric
Fuse_1210_3225Metric
SOIC-16W_7.5x10.3mm_P1.27mm
IHLP1212BZER1R0M11
C_1206_3216Metric x 2
ESP32-C3-WROOM-02
TPS2121RUXT
SOT-23-6
BatteryHolder_Multicomp_BC-2001_1x2032
mai6DF0_PCB
