trabem/home_sense_meteostation/hardware/main_board/symbols/TP5000-QFN16/TP5000-QFN16.stp

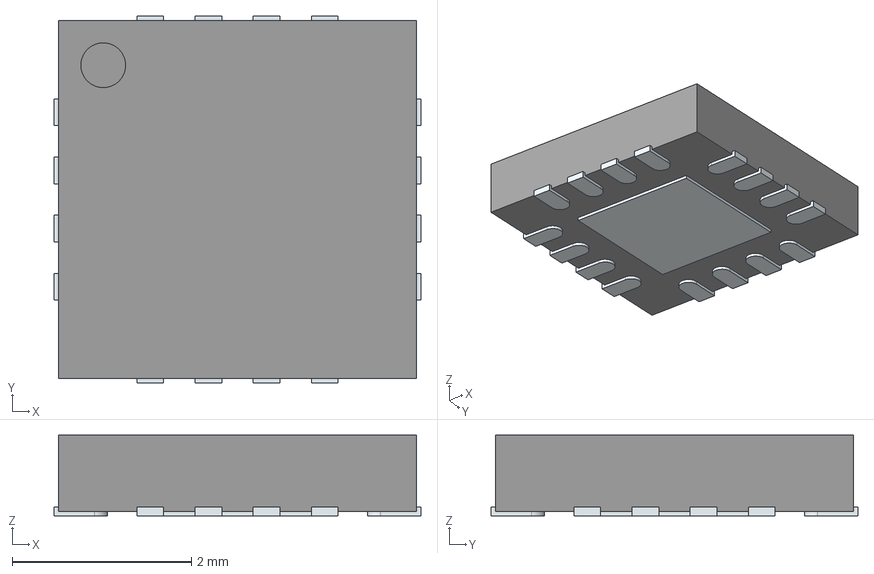
[picture p25: CAD file, 2026-09-10]
hardware/main_board/symbols/TP5000-QFN16/TP5000-QFN16.stp
4.10 x 4.10 x 0.9 mm
ThermalPin
PinsArrayLR
PinsArrayTB
