trabem/home_sense_meteostation/hardware/sensor_board/sensor_board.step

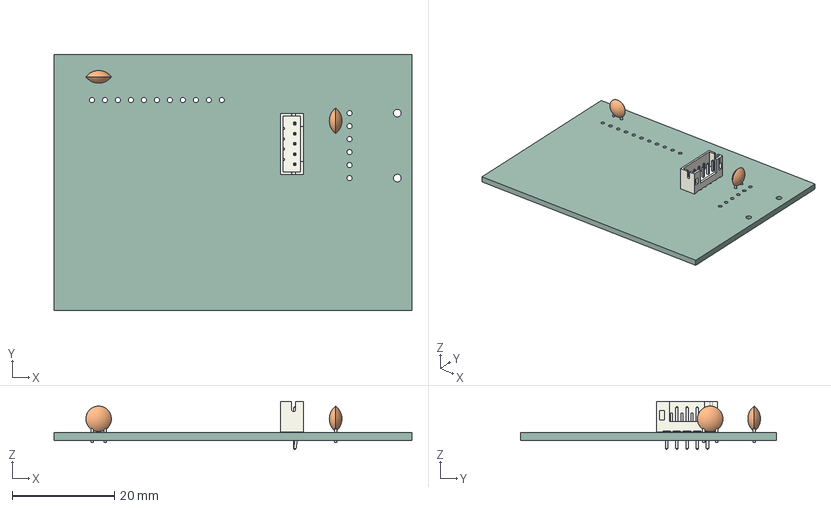
[picture p26: CAD file, 2026-10-23]
hardware/sensor_board/sensor_board.step
70.0 x 50.0 x 9.40 mm
JST_B5B_PH_K
C_Disc_D50mm_W25mm_P250mm x 2
senA09E_PCB
