trabem/home_sense_meteostation/hardware/symbols/IHLP1212BZER1R0M11/IHLP1212BZER1R0M11.step

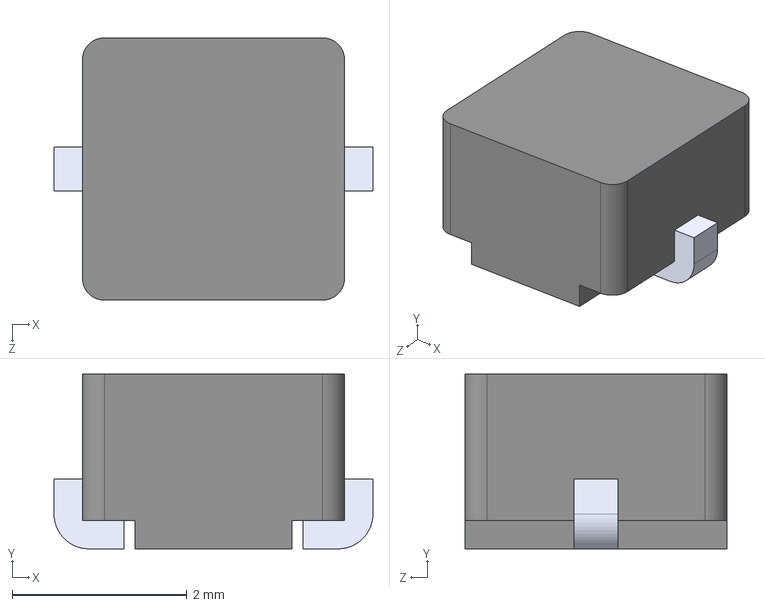
[picture p27: CAD file, 2026-08-31]
hardware/symbols/IHLP1212BZER1R0M11/IHLP1212BZER1R0M11.step
3.65 x 2.00 x 3.00 mm
