trabem/home_sense_meteostation/(list of files, cad)

Other CAD files:
hardware/main_board/main_board.stl
