trabem/home_sense_meteostation/presentation/Meteostation_Final_Project_UA_v2_Architecture.pdf

# Автономна

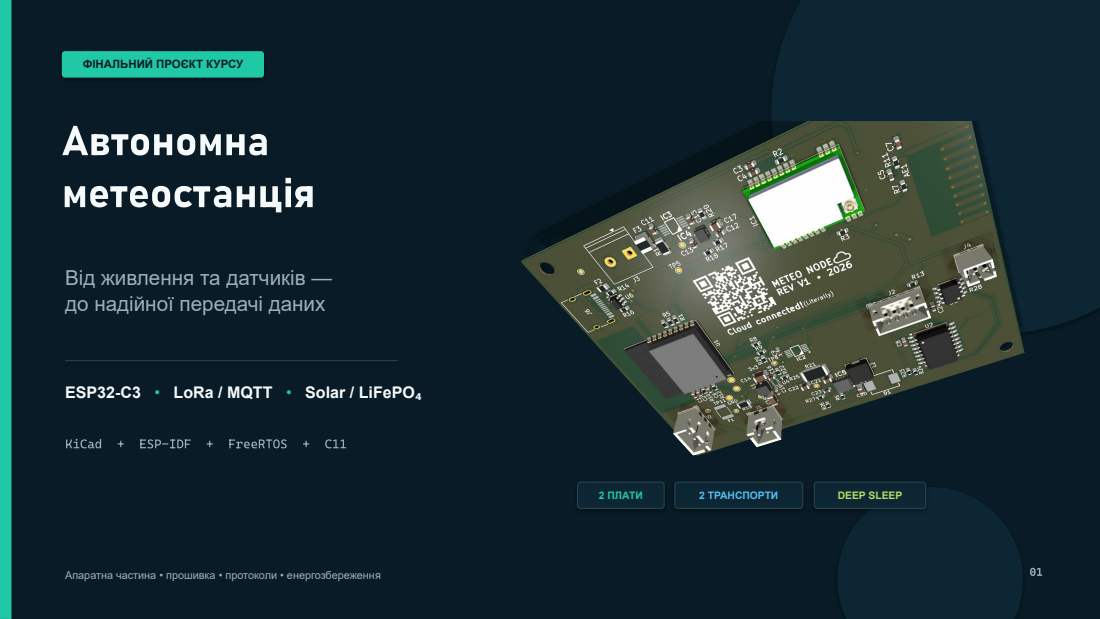
[picture p28: page 1]
метеостанція; KiCad; ESP-IDF; FreeRTOS; 2 ПЛАТИ; 2 ТРАНСПОРТИ; DEEP SLEEP; Апаратна частина • прошивка • протоколи • енергозбереження

ФІНАЛЬНИЙ ПРОЄКТ КУРСУ

Від живлення та датчиків —
до надійної передачі даних

ESP32-C3 • LoRa / MQTT • Solar / LiFePO₄

## Проблема інженерна відповідь →

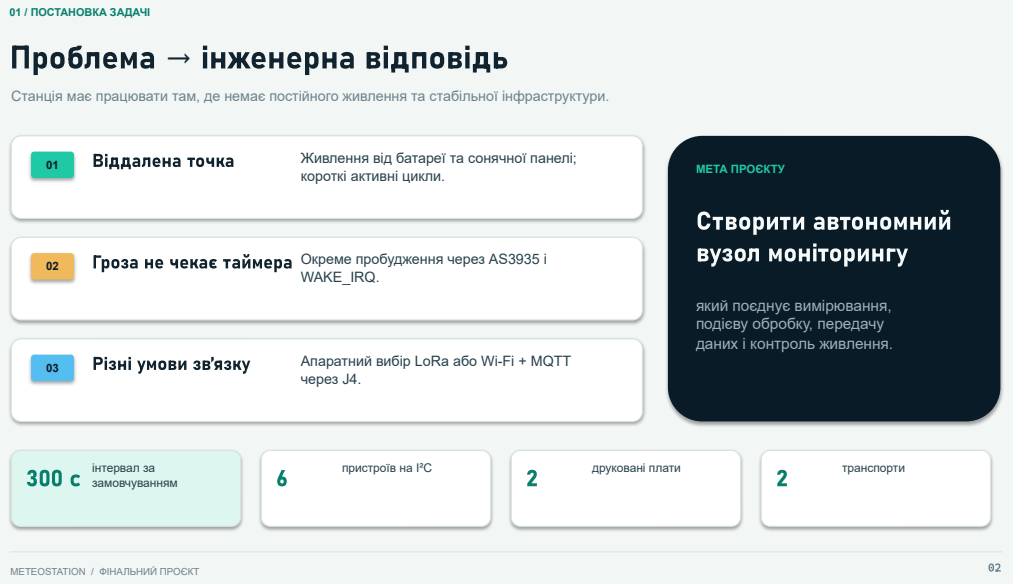
[picture p29: page 2]
01 / ПОСТАНОВКА ЗАДАЧІ; METEOSTATION / ФІНАЛЬНИЙ ПРОЄКТ; Віддалена точка; Живлення від батареї та сонячної панелі;; WAKE_IRQ.; Різні умови зв’язку; Апаратний вибір LoRa або Wi-Fi + MQTT; через J4.; МЕТА ПРОЄКТУ; Створити автономний; вузол моніторингу; 300 с інтервал за; замовчуванням; пристроїв на I²C; друковані плати; транспорти

Станція має працювати там, де немає постійного живлення та стабільної інфраструктури.

короткі активні цикли.

02 Гроза не чекає таймера Окреме пробудження через AS3935 і

який поєднує вимірювання,
подієву обробку, передачу
даних і контроль живлення.

## Система в одному погляді

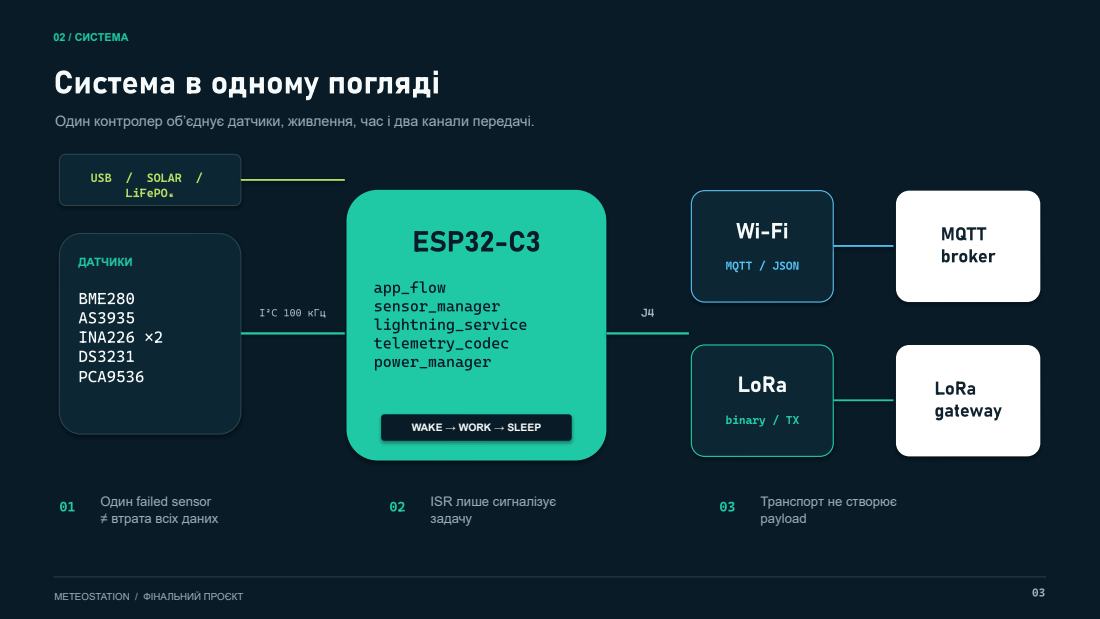
[picture p30: page 3]
02 / СИСТЕМА; USB; SOLAR; LiFePO₄; ДАТЧИКИ; BME280 AS3935 INA226 ×2 DS3231 PCA9536; I²C 100 кГц; ESP32-C3; app_flow; sensor_manager lightning_service; telemetry_codec; power_manager; MQTT / JSON; LoRa; binary / TX; MQTT; broker; gateway; Один failed sensor; ISR лише сигналізує; задачу; Транспорт не створює; payload

Один контролер об’єднує датчики, живлення, час і два канали передачі.

WAKE → WORK → SLEEP

≠ втрата всіх даних

## Дві плати, один автономний вузол

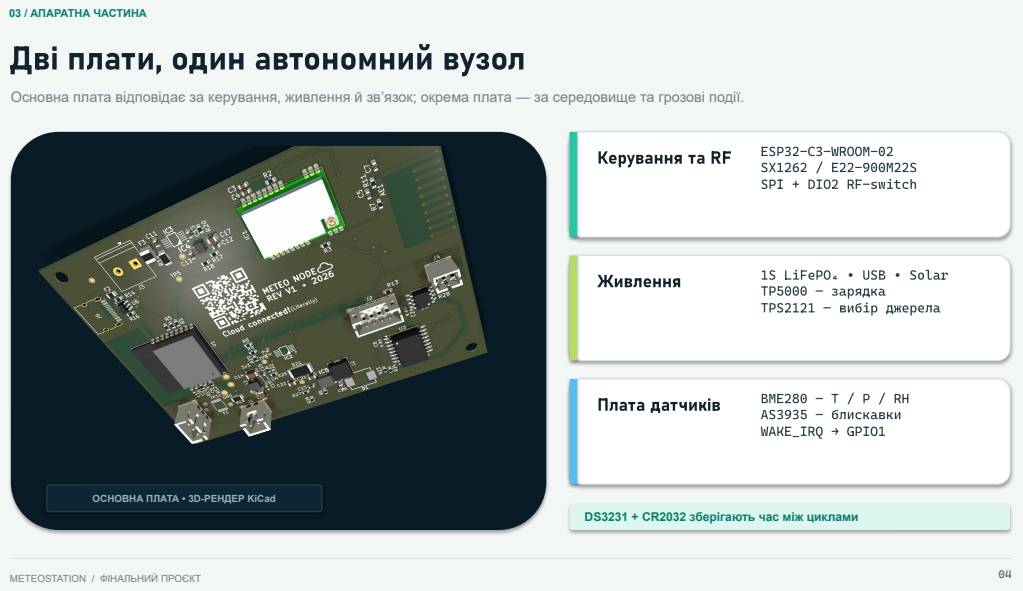
[picture p31: page 4]
03 / АПАРАТНА ЧАСТИНА; Керування та RF; ESP32-C3-WROOM-02; Живлення; 1S LiFePO₄ • USB • Solar; TP5000 — зарядка; TPS2121 — вибір джерела; Плата датчиків; BME280 — T / P / RH; AS3935 — блискавки WAKE_IRQ → GPIO1

Основна плата відповідає за керування, живлення й зв’язок; окрема плата — за середовище та грозові події.

SPI + DIO2 RF-switch

ОСНОВНА ПЛАТА • 3D-РЕНДЕР KiCad

DS3231 + CR2032 зберігають час між циклами

## Що саме вимірює станція

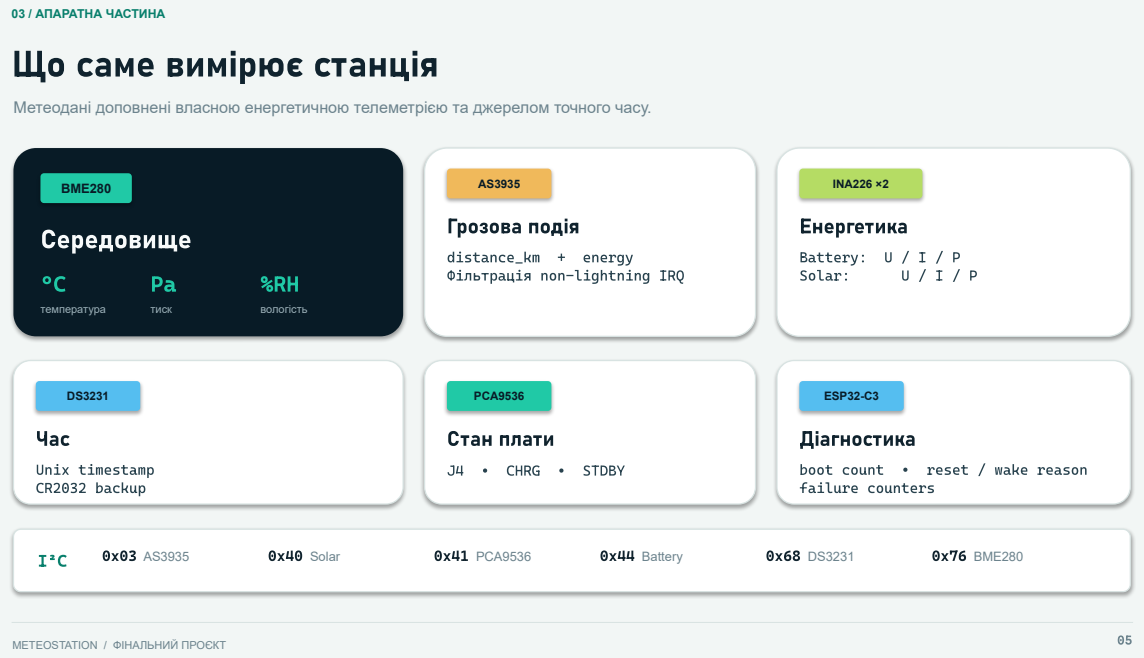
[picture p32: page 5]
03 / АПАРАТНА ЧАСТИНА; BME280; Середовище; температура; тиск; вологість; Грозова подія; distance_km; energy; INA226 ×2; Енергетика; Battery:; Solar:; Час; Unix timestamp CR2032 backup; PCA9536; Стан плати; CHRG; STDBY; ESP32-C3; Діагностика; boot count; reset / wake reason; failure counters; I²C; 0x40 Solar; 0x41 PCA9536; 0x44 Battery; 0x76 BME280

Метеодані доповнені власною енергетичною телеметрією та джерелом точного часу.

Фільтрація non-lightning IRQ

## Компонентна архітектура ESP-IDF

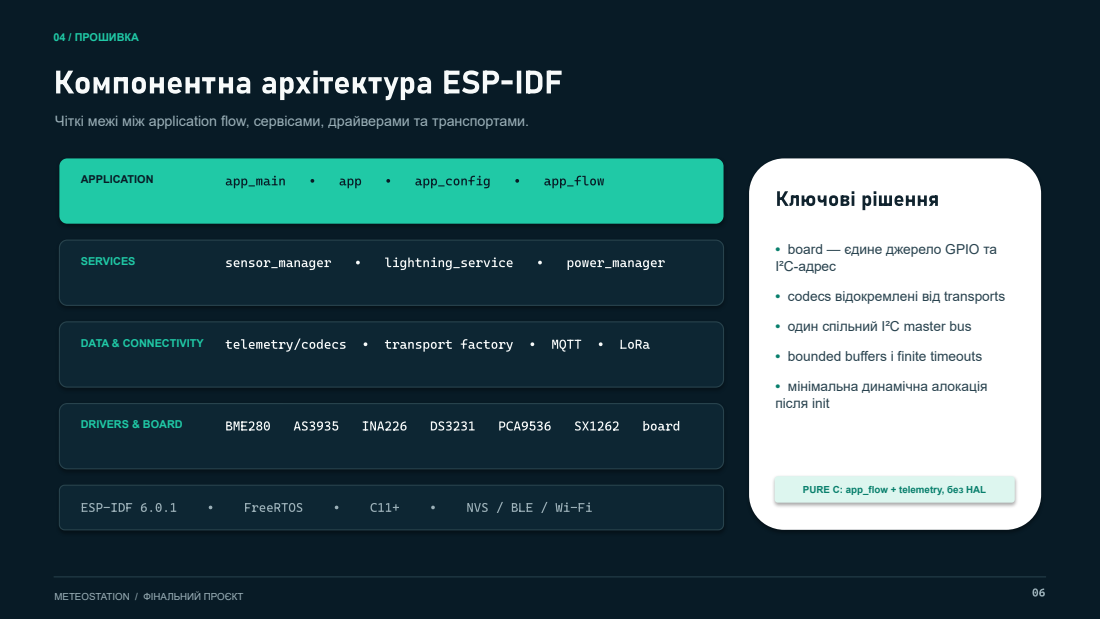
[picture p33: page 6]
04 / ПРОШИВКА; APPLICATION; app_main; app; app_config; app_flow; SERVICES; sensor_manager; lightning_service; power_manager; DATA & CONNECTIVITY; telemetry/codecs; transport factory; MQTT; LoRa; DRIVERS & BOARD; BME280; INA226; PCA9536; board; ESP-IDF 6.0.1; FreeRTOS; NVS / BLE / Wi-Fi; Ключові рішення

Чіткі межі між application flow, сервісами, драйверами та транспортами.

• board — єдине джерело GPIO та
I²C-адрес

• codecs відокремлені від transports

• один спільний I²C master bus

• bounded buffers і finite timeouts

• мінімальна динамічна алокація
після init

PURE C: app_flow + telemetry, без HAL

## Concurrency: мінімум задач, явна синхронізація

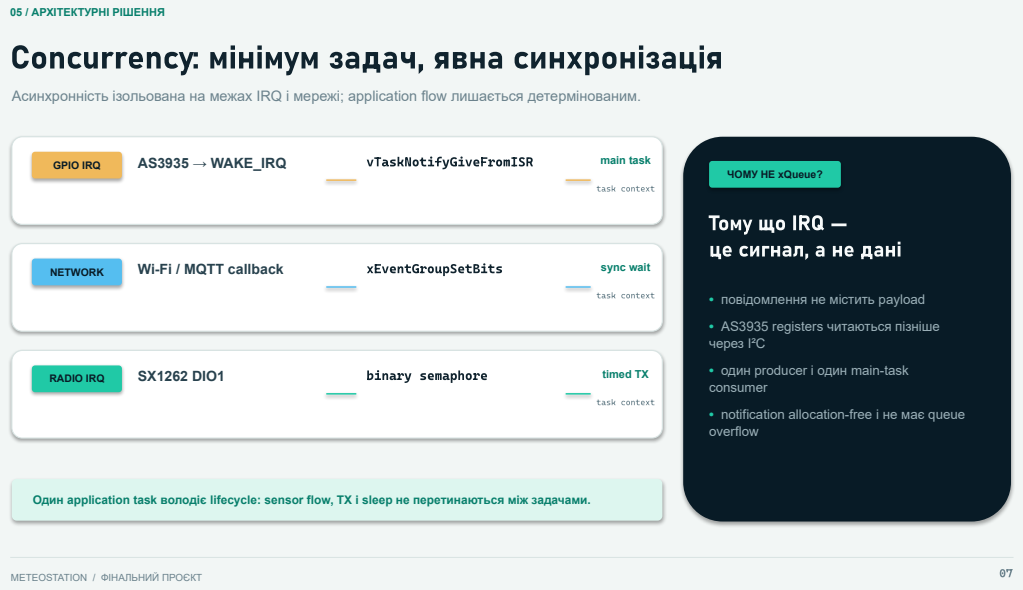
[picture p34: page 7]
05 / АРХІТЕКТУРНІ РІШЕННЯ; GPIO IRQ; AS3935 → WAKE_IRQ; vTaskNotifyGiveFromISR; main task; task context; NETWORK; Wi-Fi / MQTT callback; xEventGroupSetBits; sync wait; RADIO IRQ; SX1262 DIO1; binary semaphore; timed TX

Асинхронність ізольована на межах IRQ і мережі; application flow лишається детермінованим.

ЧОМУ НЕ xQueue?

Тому що IRQ —
це сигнал, а не дані

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

Один application task володіє lifecycle: sensor flow, TX і sleep не перетинаються між задачами.

## Persistent queue: свідомо не в V1

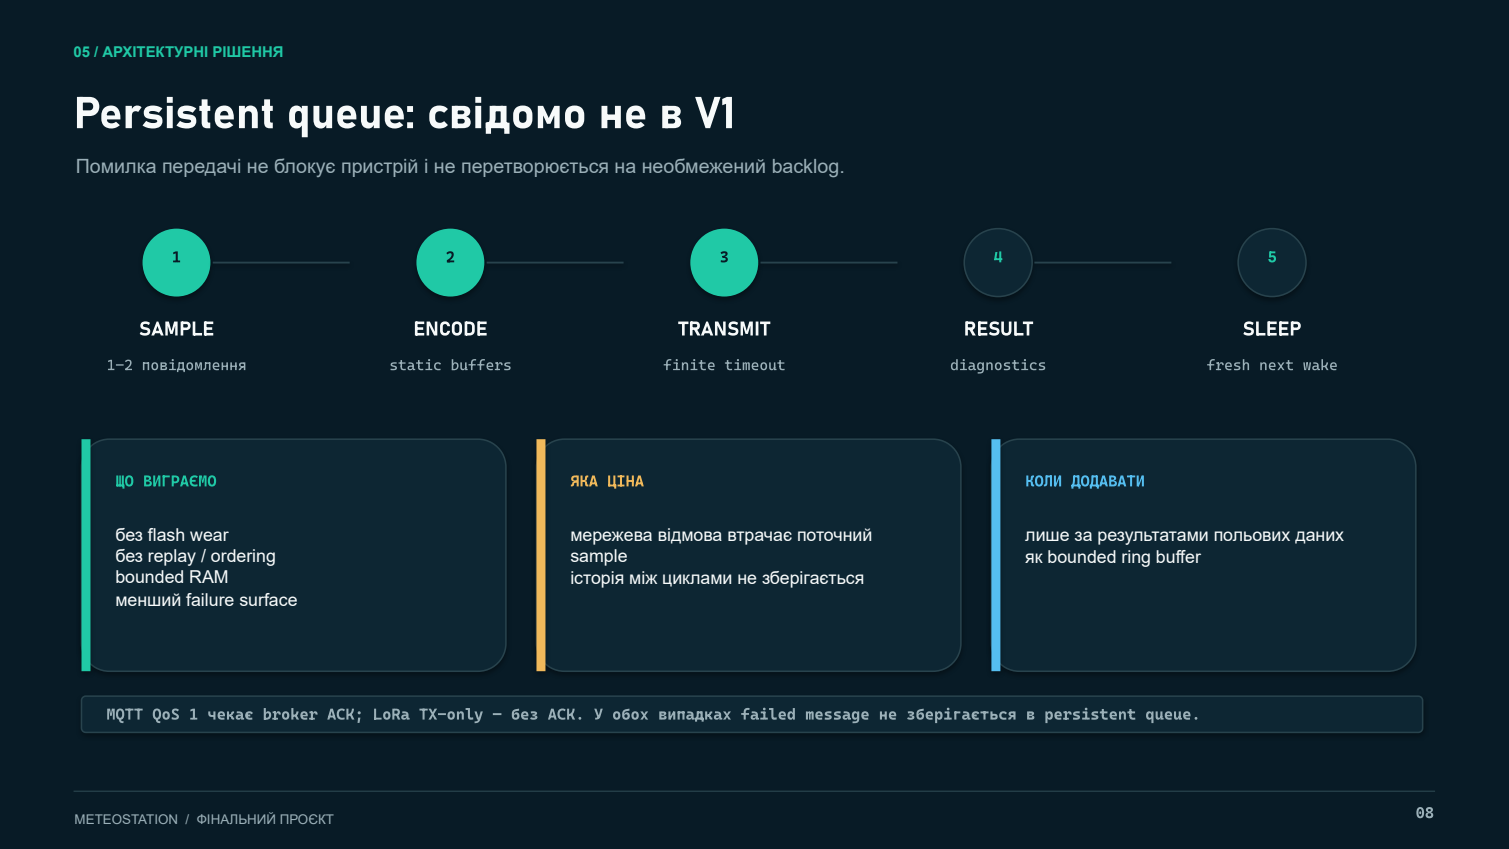
[picture p35: page 8]
05 / АРХІТЕКТУРНІ РІШЕННЯ; SAMPLE; 1–2 повідомлення; ENCODE; static buffers; TRANSMIT; finite timeout; RESULT; diagnostics; SLEEP; ЩО ВИГРАЄМО; ЯКА ЦІНА; КОЛИ ДОДАВАТИ

Помилка передачі не блокує пристрій і не перетворюється на необмежений backlog.

fresh next wake

без flash wear
без replay / ordering
bounded RAM
менший failure surface

мережева відмова втрачає поточний
sample
історія між циклами не зберігається

лише за результатами польових даних
як bounded ring buffer

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

## Deep sleep — основний стан системи

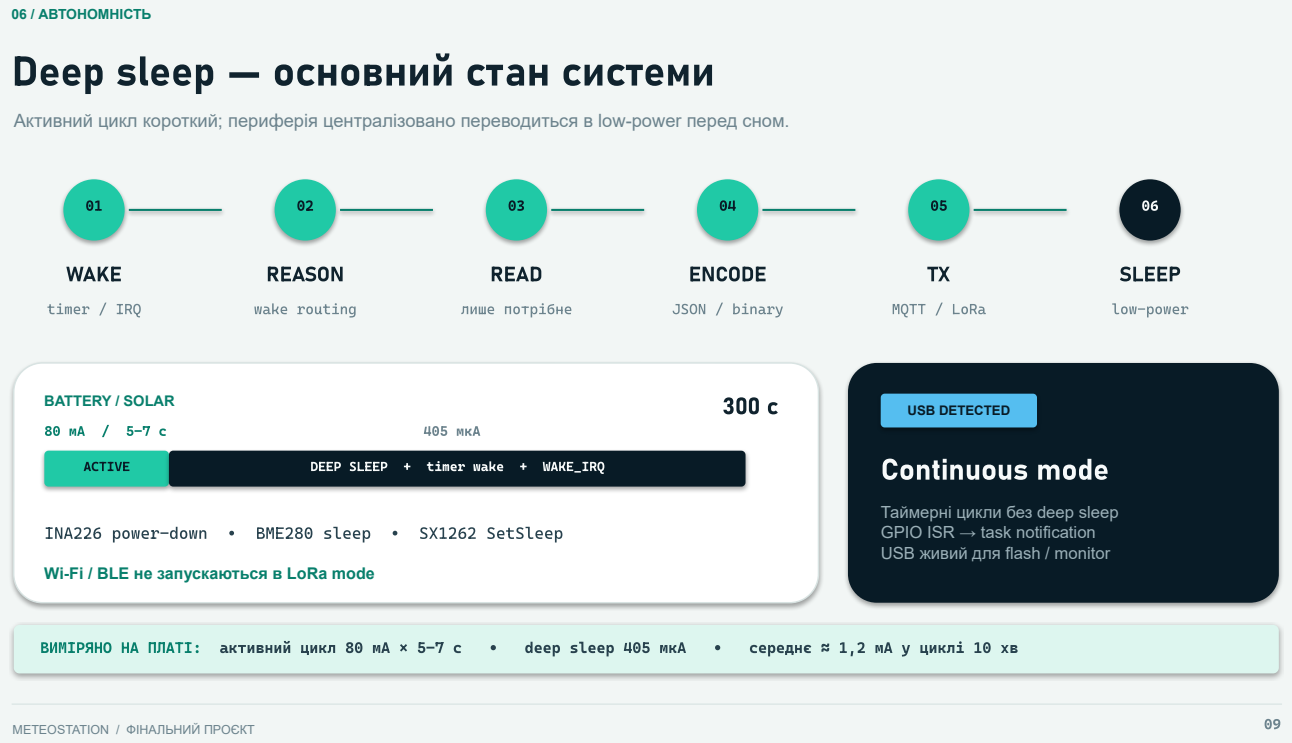
[picture p36: page 9]
06 / АВТОНОМНІСТЬ; WAKE; timer / IRQ; REASON; wake routing; READ; лише потрібне; ENCODE; JSON / binary; MQTT / LoRa; SLEEP; low-power; BATTERY / SOLAR; 405 мкА; ACTIVE; DEEP SLEEP; timer wake; WAKE_IRQ; INA226 power-down; BME280 sleep; SX1262 SetSleep; USB DETECTED; Continuous mode; ВИМІРЯНО НА ПЛАТІ:; активний цикл 80 мА × 5–7 с; deep sleep 405 мкА; середнє ≈ 1,2 мА у циклі 10 хв

Активний цикл короткий; периферія централізовано переводиться в low-power перед сном.

Таймерні цикли без deep sleep
GPIO ISR → task notification
USB живий для flash / monitor

Wi-Fi / BLE не запускаються в LoRa mode

## Блискавка: окремий швидкий сценарій

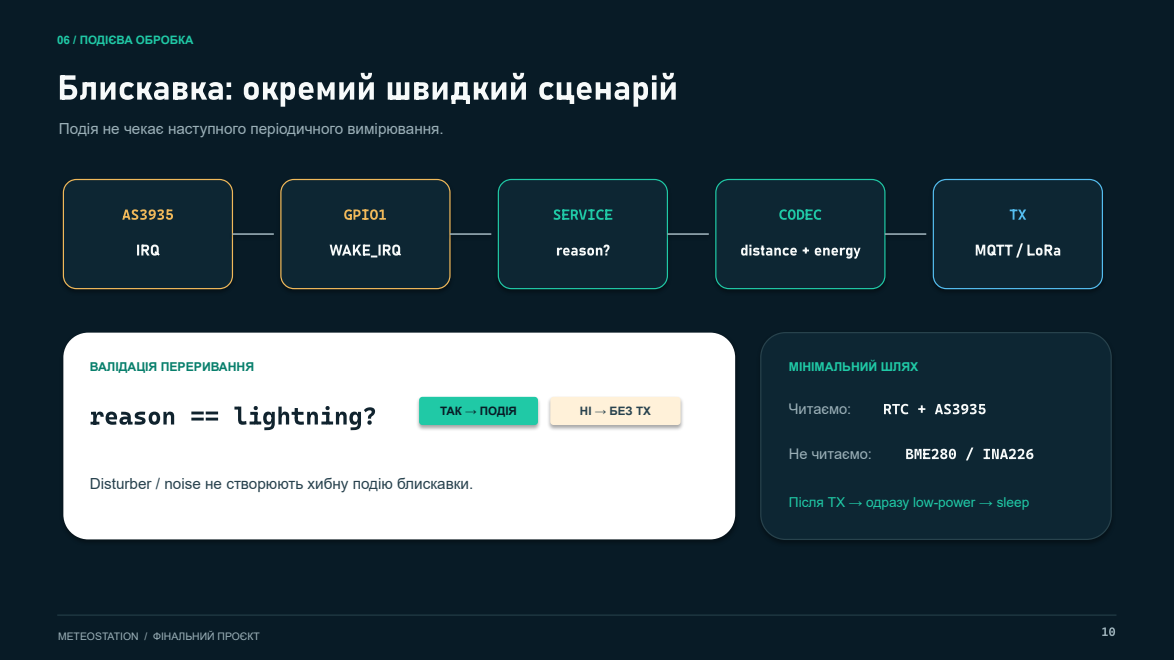
[picture p37: page 10]
06 / ПОДІЄВА ОБРОБКА; IRQ; GPIO1; WAKE_IRQ; SERVICE; reason?; CODEC; distance + energy; MQTT / LoRa; ВАЛІДАЦІЯ ПЕРЕРИВАННЯ; reason == lightning?; ТАК → ПОДІЯ; НІ → БЕЗ TX; МІНІМАЛЬНИЙ ШЛЯХ; Читаємо:; RTC + AS3935; Не читаємо:; BME280 / INA226

Подія не чекає наступного періодичного вимірювання.

Disturber / noise не створюють хибну подію блискавки.

Після TX → одразу low-power → sleep

## J4 — явний вибір транспорту

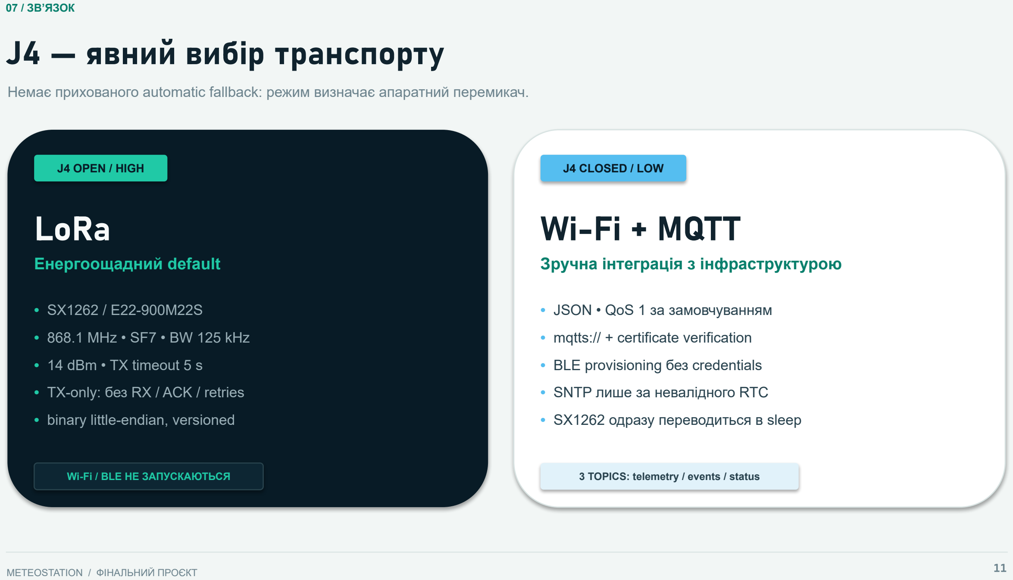
[picture p38: page 11]

07 / ЗВ’ЯЗОК

Немає прихованого automatic fallback: режим визначає апаратний перемикач.

J4 OPEN / HIGH

## LoRa

Енергоощадний default

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

Wi-Fi / BLE НЕ ЗАПУСКАЮТЬСЯ

J4 CLOSED / LOW

## Wi-Fi + MQTT

Зручна інтеграція з інфраструктурою

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

### 3 TOPICS: telemetry / events / status

## Два формати — одна предметна модель

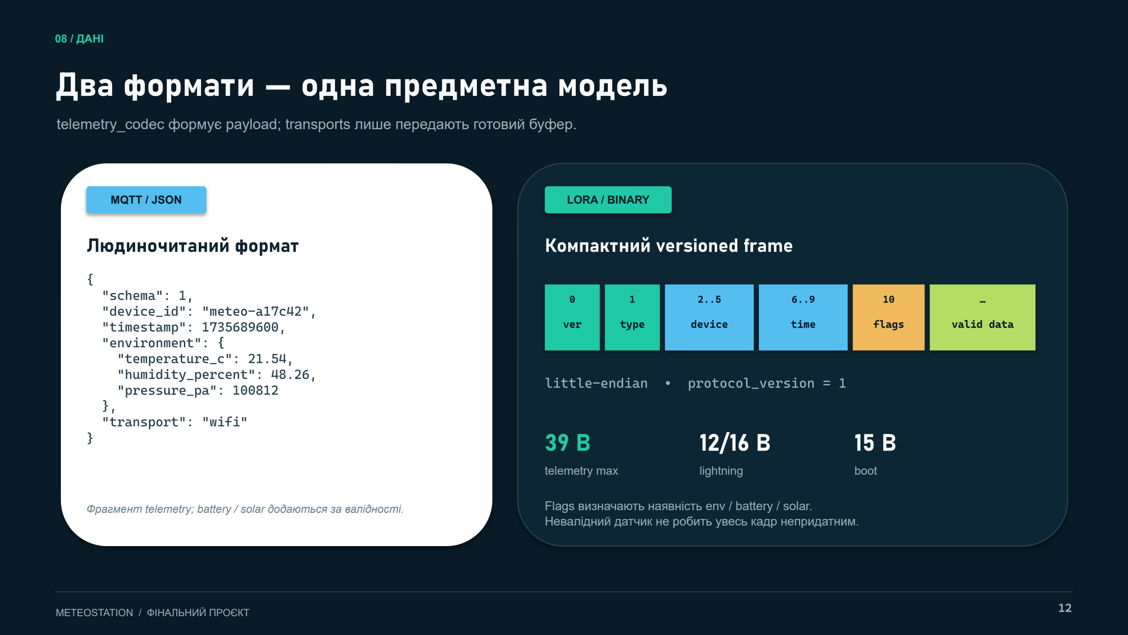
[picture p39: page 12]

08 / ДАНІ

telemetry_codec формує payload; transports лише передають готовий буфер.

MQTT / JSON

Людиночитаний формат

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

Фрагмент telemetry; battery / solar додаються за валідності.

LORA / BINARY

Компактний versioned frame

0

ver

1

type

2..5

device

6..9

time

10

flags

…

valid data

little-endian | • | protocol_version = 1

39 B

telemetry max

12/16 B

lightning

15 B

boot

Flags визначають наявність env / battery / solar. Невалідний датчик не робить увесь кадр непридатним.

## Надійність і безпека закладені в потік

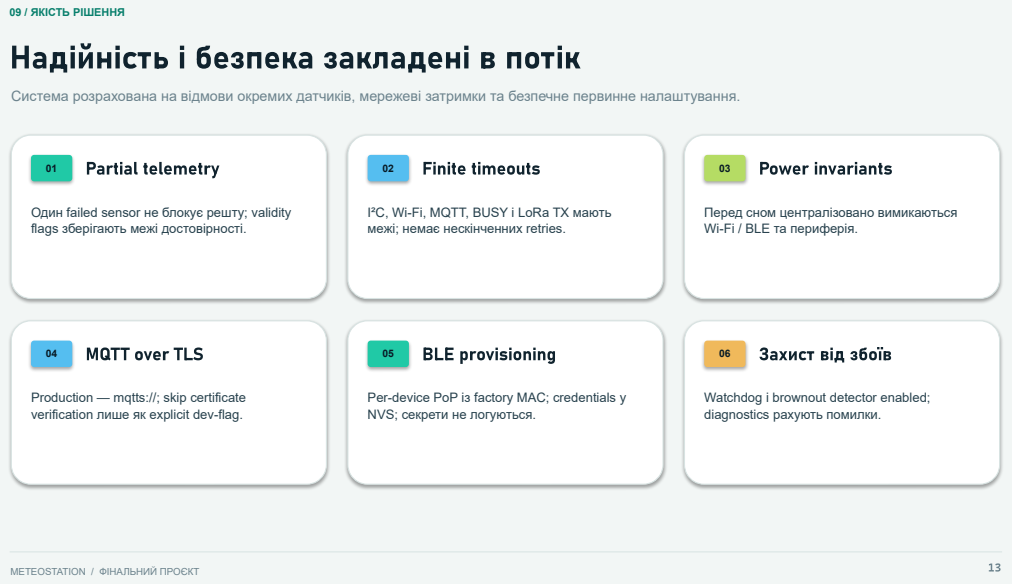
[picture p40: page 13]
09 / ЯКІСТЬ РІШЕННЯ; 01 Partial telemetry; 02 Finite timeouts; 03 Power invariants; 05 BLE provisioning

Система розрахована на відмови окремих датчиків, мережеві затримки та безпечне первинне налаштування.

Один failed sensor не блокує решту; validity
flags зберігають межі достовірності.

I²C, Wi-Fi, MQTT, BUSY і LoRa TX мають
межі; немає нескінченних retries.

Перед сном централізовано вимикаються
Wi-Fi / BLE та периферія.

04 MQTT over TLS

06 Захист від збоїв

Production — mqtts://; skip certificate
verification лише як explicit dev-flag.

Per-device PoP із factory MAC; credentials у
NVS; секрети не логуються.

Watchdog і brownout detector enabled;
diagnostics рахують помилки.

## Результат і межі поточної версії

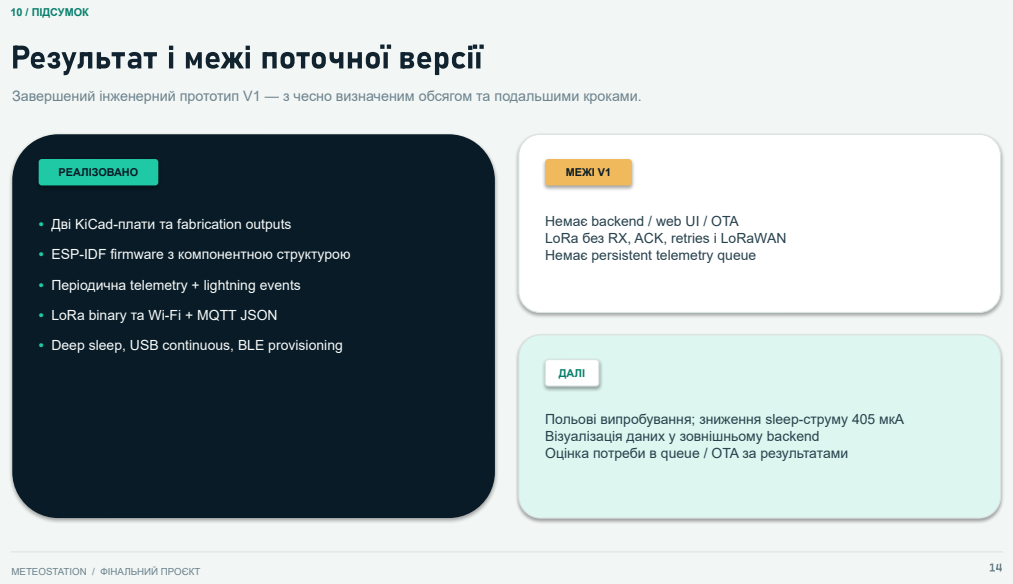
[picture p41: page 14]
10 / ПІДСУМОК; РЕАЛІЗОВАНО; МЕЖІ V1; ДАЛІ

Завершений інженерний прототип V1 — з чесно визначеним обсягом та подальшими кроками.

• Дві KiCad-плати та fabrication outputs

Немає backend / web UI / OTA
LoRa без RX, ACK, retries і LoRaWAN
Немає persistent telemetry queue

• ESP-IDF firmware з компонентною структурою

• Періодична telemetry + lightning events

• LoRa binary та Wi-Fi + MQTT JSON

• Deep sleep, USB continuous, BLE provisioning

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

# Дякую за увагу

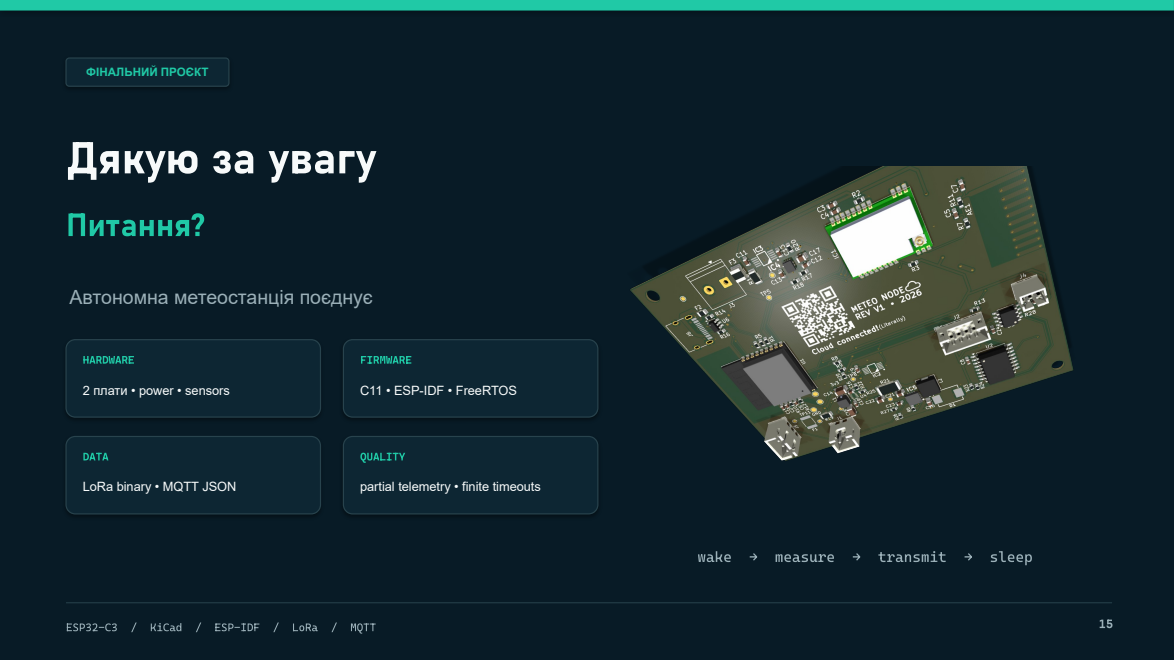
[picture p42: page 15]
ФІНАЛЬНИЙ ПРОЄКТ; Питання?; HARDWARE; FIRMWARE; DATA; QUALITY; wake; measure; transmit; sleep; ESP32-C3; / KiCad; / ESP-IDF; / LoRa; / MQTT

Автономна метеостанція поєднує

2 плати • power • sensors

C11 • ESP-IDF • FreeRTOS

LoRa binary • MQTT JSON

partial telemetry • finite timeouts
