trabem/home_sense_meteostation/(list of files, drawings)

Other design files:
hardware/main_board/freerouting.dsn
hardware/main_board/temp-freerouting.dsn
hardware/temp-freerouting.dsn
