trabem/home_sense_meteostation/hardware/sensor_board/sensor_board.kicad_pcb

## KiCad design hardware/sensor_board/sensor_board.kicad_pcb (2026-10-23)

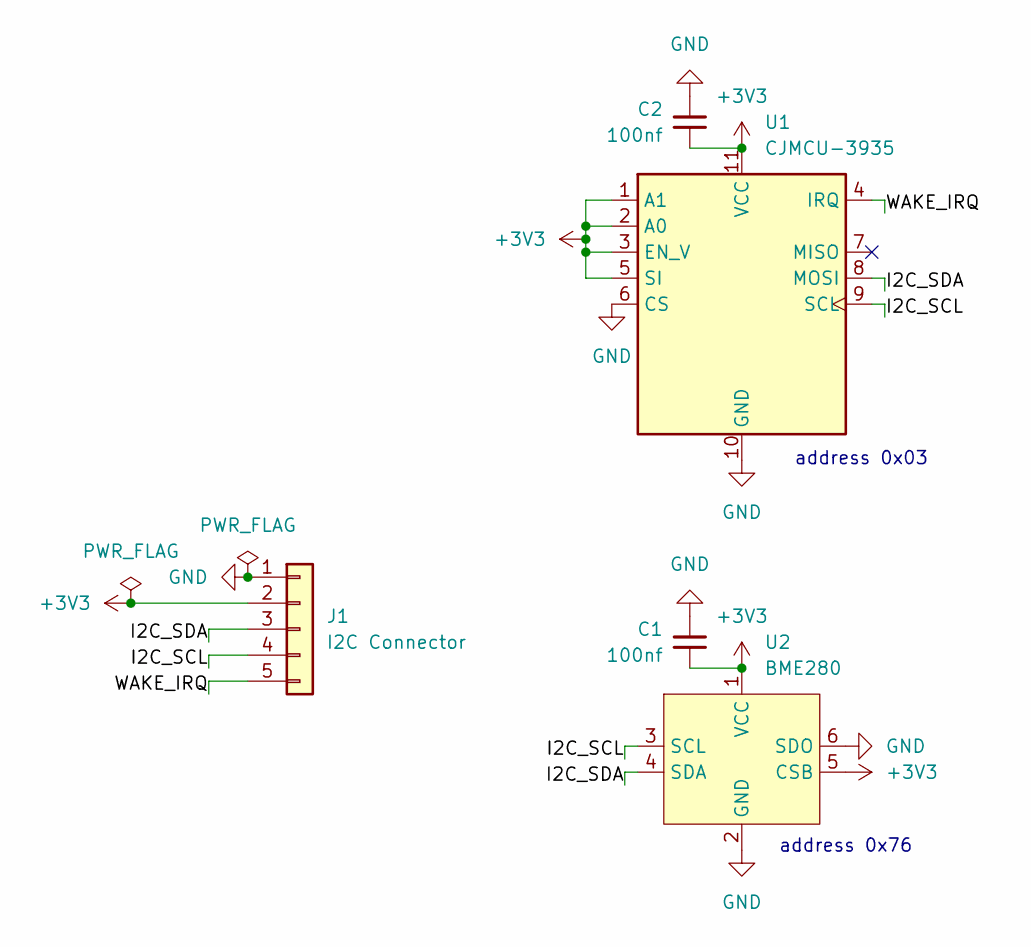
[picture p43: schematic sensor_board.kicad_sch]

Parts:
C1, C2: 100nf; C_Disc_D5.0mm_W2.5mm_P2.50mm
J1: I2C Connector; JST_PH_B5B-PH-K_1x05_P2.00mm_Vertical
U1: CJMCU-3935
U2: BME280; BME280 Module

Connections:
+3V3: C1.2, C2.2, J1.2, U1.1 (A1), U1.2 (A0), U1.3 (EN_V), U1.5 (SI), U1.11 (VCC), U2.1 (VCC), U2.5 (CSB)
/I2C_SCL: J1.4, U1.9 (SCL), U2.3 (SCL)
/I2C_SDA: J1.3, U1.8 (MOSI), U2.4 (SDA)
/WAKE_IRQ: J1.5, U1.4 (IRQ)
GND: C1.1, C2.1, J1.1, U1.6 (CS), U1.10 (GND), U2.2 (GND), U2.6 (SDO)

Notes on the sheet:
address 0x76
address 0x03

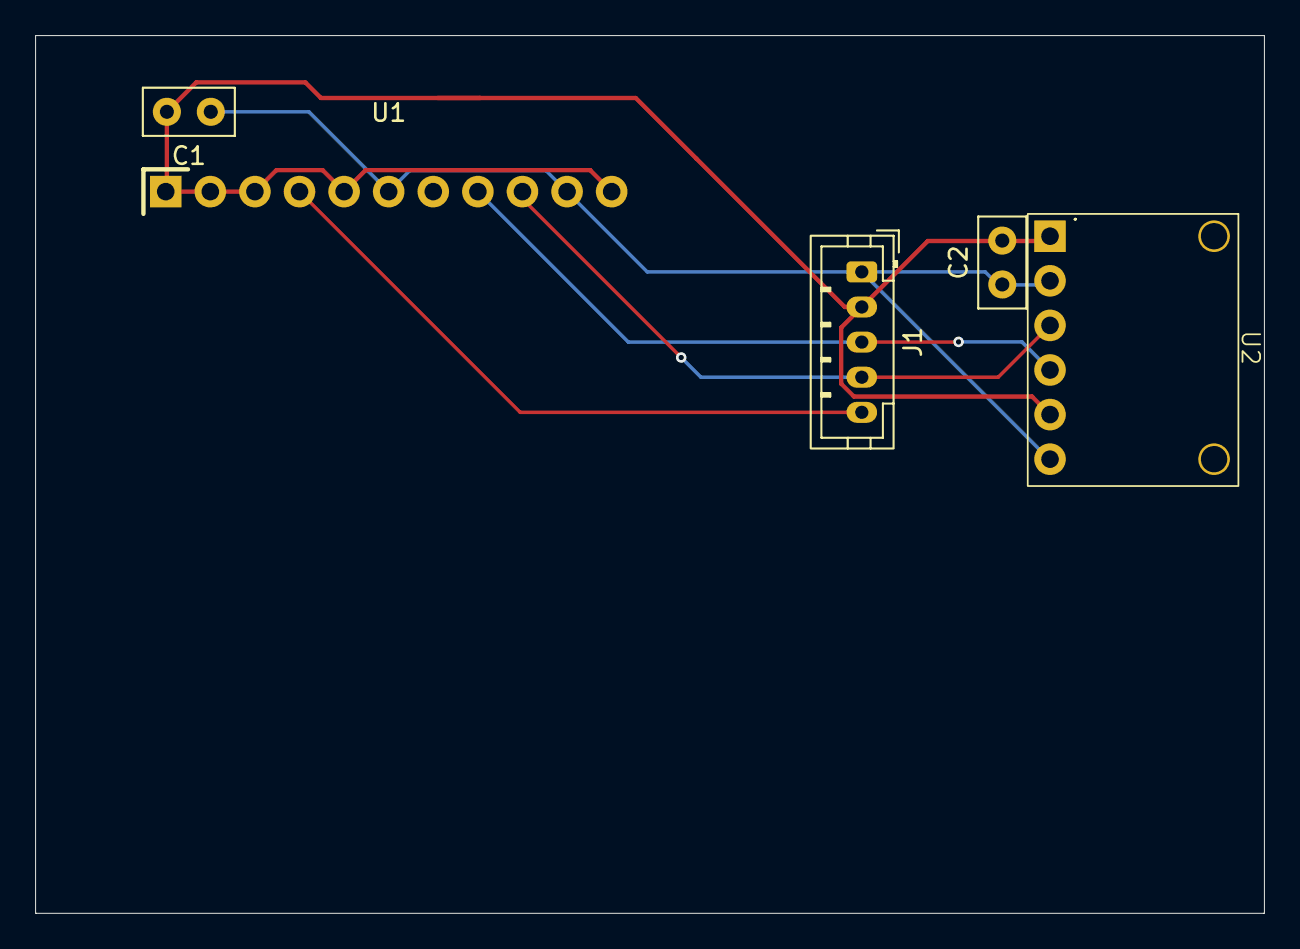
[picture p44: board sensor_board.kicad_pcb from above]

Board: 2 copper layers, 70.0 x 50.0 mm, 5 parts (0 on the bottom side), 5 nets.
