trabem/home_sense_meteostation/hardware/main_board/main_board.kicad_pcb

## KiCad design hardware/main_board/main_board.kicad_pcb (2026-10-23)

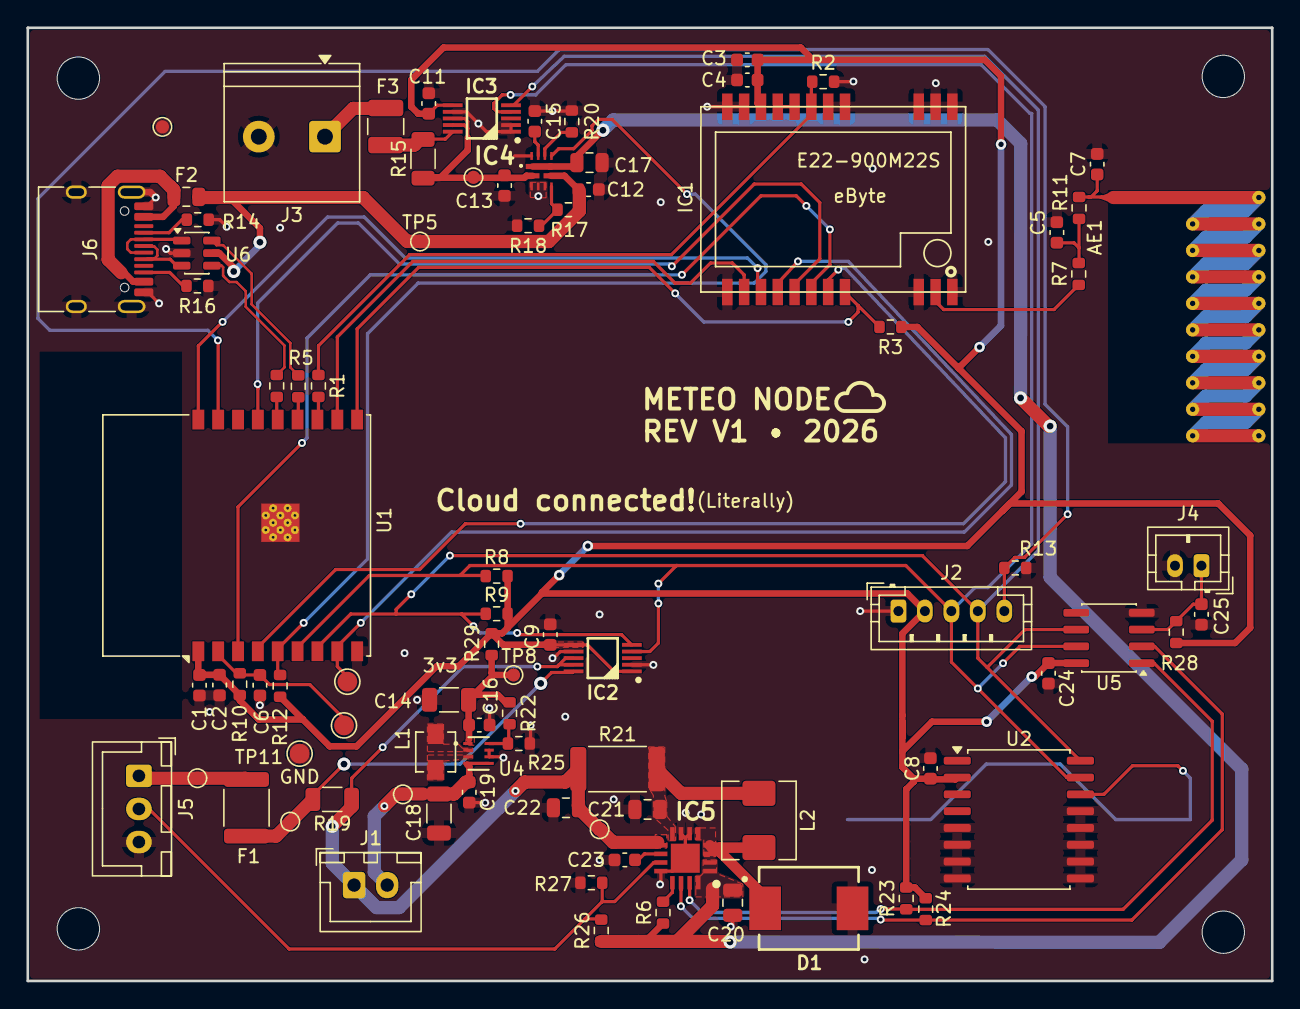
[picture p45: board main_board.kicad_pcb from above]

Board: 2 copper layers, 94.0 x 72.0 mm, 92 parts (1 on the bottom side), 54 nets.

Parts:
AE1: Antenna; Texas_SWRA416_868MHz_915MHz
BT1: CR2032; BatteryHolder_Multicomp_BC-2001_1x2032
C1, C4: 10uF; C_0603_1608Metric
C2, C3, C8, C9, C11, C15, C16, C19, C23, C24, C25: 100nF; C_0603_1608Metric
C5, C7: DNP; C_0603_1608Metric
C6, C12, C13: 1uF; C_0603_1608Metric
C14: 47uF; C_1206_3216Metric
C17: 4.7uF; C_0805_2012Metric
C18: 22uF; C_1206_3216Metric
C20, C21, C22: 10uF; C_0805_2012Metric
D1: SS34; DO-214AB
F1: MINISMDC200F-2; Fuse_1812_4532Metric
F2: 0ZCK0075FF2E; Fuse_0805_2012Metric
F3: 0ZCH0075AF2E; Fuse_1210_3225Metric
IC1: E22-900M22S
IC2, IC3: INA226AIDGST; SOP50P490X110-10N
IC4: TPS2121RUXT
IC5: TP5000-QFN16; QFN65P400X400X90-17N-D
J1: power swith; JST_XH_B2B-XH-A_1x02_P2.50mm_Vertical
J2: I2C External Modules; JST_PH_B5B-PH-K_1x05_P2.00mm_Vertical
J3: Solar panel; TerminalBlock_Philmore_TB132_1x02_P5.00mm_Horizontal
J4: WI-FI switch; JST_PH_B2B-PH-K_1x02_P2.00mm_Vertical
J5: Battary over BMS; JST_XH_B3B-XH-A_1x03_P2.50mm_Vertical
J6: USB4105-GF-A-060; USB_C_Receptacle_HRO_TYPE-C-31-M-12
L1: IHLP1212BZER1R0M11; IND_IHLP1212BZER1R0M11
L2: 4.7 uH; L_Chilisin_BMRA00050520
R1, R6, R7, R11, R29: 0R; R_0603_1608Metric
R2, R3, R10, R12, R23, R24: 10k; R_0603_1608Metric
R4, R5: 22R; R_0603_1608Metric
R8, R9: 4.7k; R_0603_1608Metric
R13, R18, R28: 47k; R_0603_1608Metric
R14, R16: 5.1k; R_0603_1608Metric
R15, R19: 20mR; R_1206_3216Metric
R17: 150k; R_0603_1608Metric
R20: 80k; R_0603_1608Metric
R21: 330mR; R_2512_6332Metric
R22: 511k; R_0603_1608Metric
R25: 91k; R_0603_1608Metric
R26: 4.87k; R_0603_1608Metric
R27: 44.2k; R_0603_1608Metric
REF1, REF2, REF3, REF4: MountingHole_3.2mm_M3
TP1: TP_SOLAR_IN; TestPoint_Pad_D1.0mm
TP2: TP_BAT_RAW; TestPoint_Pad_D1.0mm
TP3: TP_BAT_FUSED; TestPoint_Pad_D1.0mm
TP4: TP_BAT_SYSTEM; TestPoint_Pad_D1.0mm
TP5: TP_USB_5V; TestPoint_Pad_D1.0mm
TP6: ESP32_EN; TestPoint_Pad_D1.5mm
TP7: TP_BAT_SW; TestPoint_Pad_D1.0mm
TP8: TP_3V3; TestPoint_Pad_D1.0mm
TP9: TP_GND_PWR; TestPoint_Pad_D1.0mm
TP10: ESP32_BOOT; TestPoint_Pad_D1.5mm
TP11: GND; TestPoint_Pad_D1.5mm
U1: ESP32-C3-WROOM-02
U2: DS3231SN; SOIC-16W_7.5x10.3mm_P1.27mm
U4: TPS631000DRLR; TPS631000DRLR_TEX
U5: PCA9536DR; SOIC-8_3.9x4.9mm_P1.27mm
U6: USBLC6-2SC6; SOT-23-6

Connections:
+3V3: C1.1, C2.1, C3.2, C4.1, C8.2, C9.2, C11.2, C24.1, IC1.9 (VCC), IC2.1 (A1), IC2.6 (VS+), IC3.6 (VS+), J2.2, R3.2, R8.2, R9.2, R10.1, R12.2, R23.2, R24.2, R28.1, R29.2, U1.1 (3V3), U2.2 (VCC), U5.8 (VDD)
/Power/BAT_RAW: F1.1, J5.1, TP2.1 (1_1)
/Power/CHARGER_IN: C17.2, C20.1, IC4.1 (OUT_1), IC4.8 (OUT_2), IC5.1 (VIN_1), IC5.2 (VIN_2), IC5.16 (VIN_3), R6.1, R26.1
/Power/LX_SW: D1.1 (K), IC5.3 (LX_1), IC5.4 (LX_2), IC5.5 (LX_3), L2.1
/Power/NTC_SENSE: IC5.11 (TS), J5.2, R26.2, R27.1
/Power/USB_5V: C12.2, F2.2, IC4.7 (IN1), R17.2, TP5.1 (1_1), U6.5 (VBUS)
/main_board/I2C_SCL: IC2.5 (SCL), IC3.5 (SCL), J2.4, R9.1, U1.7 (IO8), U2.16 (SCL), U5.6 (SCL)
/main_board/I2C_SDA: IC2.4 (SDA), IC3.4 (SDA), J2.3, R8.1, U1.6 (IO7), U2.15 (SDA), U5.7 (SDA)
/main_board/LORA_BUSY: IC1.14 (BUSY), U1.18 (IO0)
/main_board/LORA_DIO1: IC1.13 (DIO1), U1.11 (IO20/RXD)
/main_board/LORA_NRST: IC1.15 (NRST), TP10.1 (1_1), U1.8 (IO9)
/main_board/LORA_NSS: IC1.19 (NSS), R3.1, U1.10 (IO10)
/main_board/LORA_RXEN: IC1.6 (RXEN), R1.1, R2.1
/main_board/LORA_TXEN: IC1.7 (TXEN), IC1.8 (DIO2)
/main_board/SPI_MISO: IC1.16 (MISO), U1.15 (IO3)
/main_board/SPI_MOSI: IC1.17 (MOSI), U1.3 (IO4)
/main_board/SPI_SCK: IC1.18 (SCK), U1.4 (IO5)
/main_board/WAKE_IRQ: J2.5, R13.1, U1.17 (IO1)
/main_board/WIFI_SW: C25.2, J4.1, R28.2, U5.3 (IO2)
BAT_FUSED: F1.2, IC2.10 (VIN+), R19.2, TP3.1 (1_1)
BAT_SW: C22.1, IC2.8 (VBUS), IC2.9 (VIN-), IC5.9 (BAT), J1.1, R19.1, R21.1, TP7.1 (1_1)
BAT_SYSTEM: C18.1, C19.1, J1.2, TP4.1 (1_1), U4.4 (VIN), U4.5 (EN)
BT_CR2032: BT1.1 (+), U2.14 (VBAT)
CHARGE_SOURCE_STATUS_OUT: IC4.9 (ST), R12.1, U1.5 (IO6)
CHRG_STATUS: IC5.15 (~CHRG), R23.1, U5.1 (IO0)
GND: BT1.2 (-), C1.2, C2.2, C3.1, C4.2, C5.2, C6.2, C7.2, C8.1, C9.1, C11.1, C12.1, C13.1, C14.2, C15.1, C16.2, C17.1, C18.2, C19.2, C20.2, C21.2, C22.2, C23.2, C24.2, C25.1, D1.2 (A), IC1.1 (GND), IC1.2 (GND), IC1.3 (GND), IC1.4 (GND), IC1.5 (GND), IC1.10 (GND), IC1.11 (GND), IC1.12 (GND), IC1.20 (GND), IC1.22 (GND), IC2.2 (A0), IC2.7 (GND), IC3.1 (A1), IC3.2 (A0), IC3.7 (GND), IC4.3 (CP2), IC4.4 (OV2), IC4.5 (OV1), IC4.12 (GND), IC5.6 (GND_1), IC5.7 (GND_2), IC5.12 (RTRICK), IC5.17 (EP), J2.1, J3.2, J4.2, J5.3, J6.A1 (GND), J6.A12 (GND), J6.B1 (GND), J6.B12 (GND), J6.SH (SHIELD), R2.2, R13.2, R14.1, R16.2, R18.1, R20.2, R25.2, R27.2, TP9.1 (1_1), TP11.1 (1_1), U1.9 (GND), U1.19 (GND), U2.5 (GND), U2.6 (GND), U2.7 (GND), U2.8 (GND), U2.9 (GND), U2.10 (GND), U2.11 (GND), U2.12 (GND), U2.13 (GND), U4.6 (MODE), U4.7 (GND), U5.4 (VSS), U6.2 (GND)
unnamed: AE1.1 (A_1), C7.1, R11.2
unnamed: C5.1, R7.2, R11.1
unnamed: F2.1, J6.A4 (VBUS), J6.A9 (VBUS), J6.B4 (VBUS), J6.B9 (VBUS)
unnamed: IC1.21 (ANT), R7.1
unnamed: IC4.10 (ILIM), R20.1
unnamed: IC4.6 (PR1), R17.1, R18.2
unnamed: C15.2, IC4.11 (SS)
unnamed: IC5.13 (CS), R6.2
unnamed: C23.1, IC5.10 (VREG)
unnamed: C21.1, IC5.8 (VS), L2.2, R21.2
unnamed: F3.1, J3.1
unnamed: J6.A5 (CC1), R14.2
unnamed: J6.B5 (CC2), R16.1
unnamed: J6.A6 (D+), J6.B6 (D+), U6.3 (I/O2)
unnamed: J6.A7 (D-), J6.B7 (D-), U6.1 (I/O1)
unnamed: C6.1, R10.2, TP6.1 (1_1), U1.2 (EN)
unnamed: R5.1, U1.13 (IO18)
unnamed: R4.2, U1.14 (IO19)
unnamed: R1.2, U1.12 (IO21/TXD)
unnamed: R22.2, R25.1, U4.8 (FB)
unnamed: L1.1, U4.3 (LX1)
unnamed: L1.2, U4.2 (LX2)
unnamed: C14.1, C16.1, R22.1, R29.1, TP8.1 (1_1), U4.1 (VOUT)
SOLAR+: F3.2, IC3.10 (VIN+), R15.2
SOLAR_IN: C13.2, IC3.8 (VBUS), IC3.9 (VIN-), IC4.2 (IN2), R15.1, TP1.1 (1_1)
STDBY_STATUS: IC5.14 (~STDBY), R24.1, U5.2 (IO1)
USB_D+: R4.1, U6.4 (I/O2)
USB_D-: R5.2, U6.6 (I/O1)
