trabem/home_sense_meteostation/(commit log)

2026-09-03 hardware: power
2026-09-04 hardware schematic draft
2026-09-04 hardware improve i2c
2026-09-10 hw stage 2
2026-09-13 hw start board
2026-09-14 hw pcb
2026-09-14 hw pcb v0.2
2026-09-14 hw pcb v0.3
2026-09-15 hw gerber files
2026-09-16 hw v1 resize board
2026-09-16 hw v1 wi-fi switch
2026-09-22 hw v1 battery selection
